Triton-AI/evGoKart-mechanical-system/evGo-Kart CAD/steering frame/156B True Steering_Kart Assembly.gif

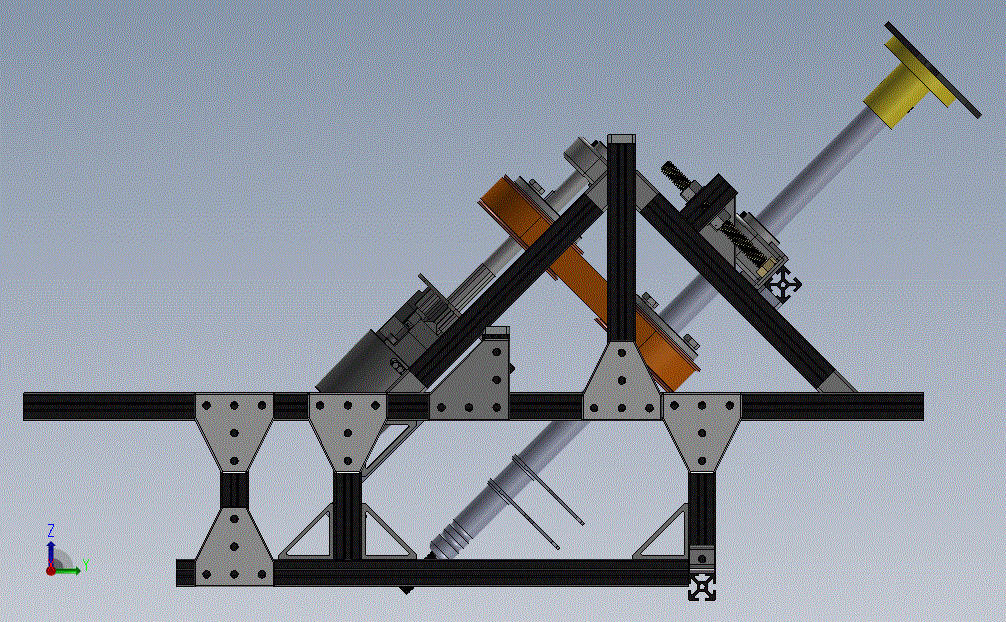
evGo-Kart CAD/steering frame/156B True Steering_Kart Assembly.gif
