Triton-AI/evGoKart-mechanical-system/evGo-Kart CAD/camera system/Livox Lidar Assembly_proto.jpg

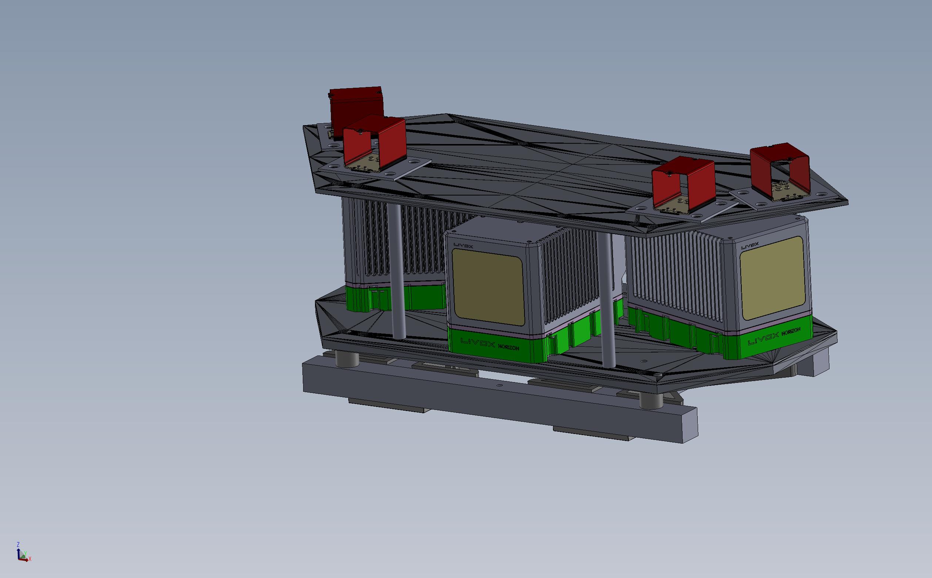
evGo-Kart CAD/camera system/Livox Lidar Assembly_proto.jpg
