Triton-AI/evGoKart-mechanical-system/evGo-Kart CAD/camera system/Go-Kart & Perception SW files/steering motor assembly comp/MAXPlanetary 3-Stage.STEP.SLDASM

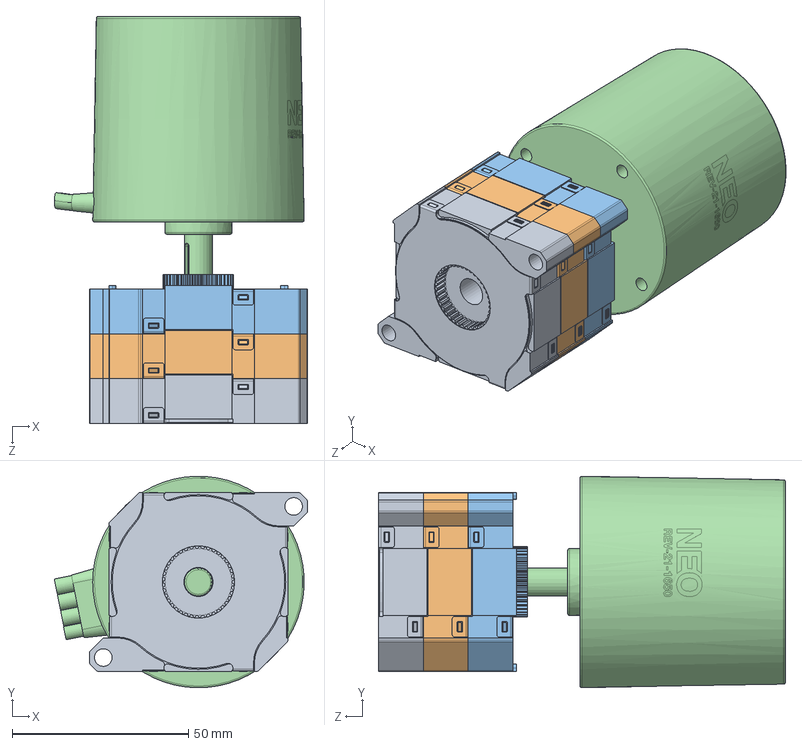
[picture p3: CAD file, 2022-07-24]
evGo-Kart CAD/camera system/Go-Kart & Perception SW files/steering motor assembly comp/MAXPlanetary 3-Stage.STEP.SLDASM
71.8 x 60.0 x 115.4 mm
REV-21-2101.stp
REV-21-2102.stp
REV-21-2103.stp
REV-21-1650.stp
