Triton-AI/evGoKart-mechanical-system/evGo-Kart CAD/steering frame/True Steering_Kart Assembly SolidWorks files/Custom Parts and Sub-Assemblies/Steering Belt Adjustment Mount/Steering Mount and Adjuster Main.STL

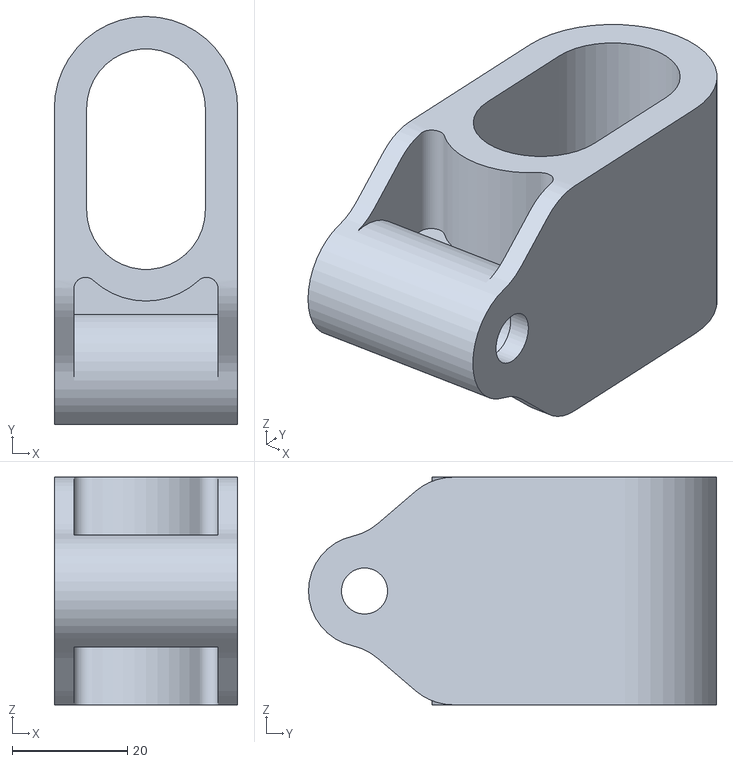
[picture p4: CAD file, 2022-07-23]
evGo-Kart CAD/steering frame/True Steering_Kart Assembly SolidWorks files/Custom Parts and Sub-Assemblies/Steering Belt Adjustment Mount/Steering Mount and Adjuster Main.STL
31.8 x 70.8 x 39.5
