Triton-AI/evGoKart-mechanical-system/evGo-Kart CAD/camera system/Go-Kart & Perception SW files/MAXPlanetary 3 parts/REV-25-2109_3-Stage (No Shaft, For NEO).STEP.SLDASM

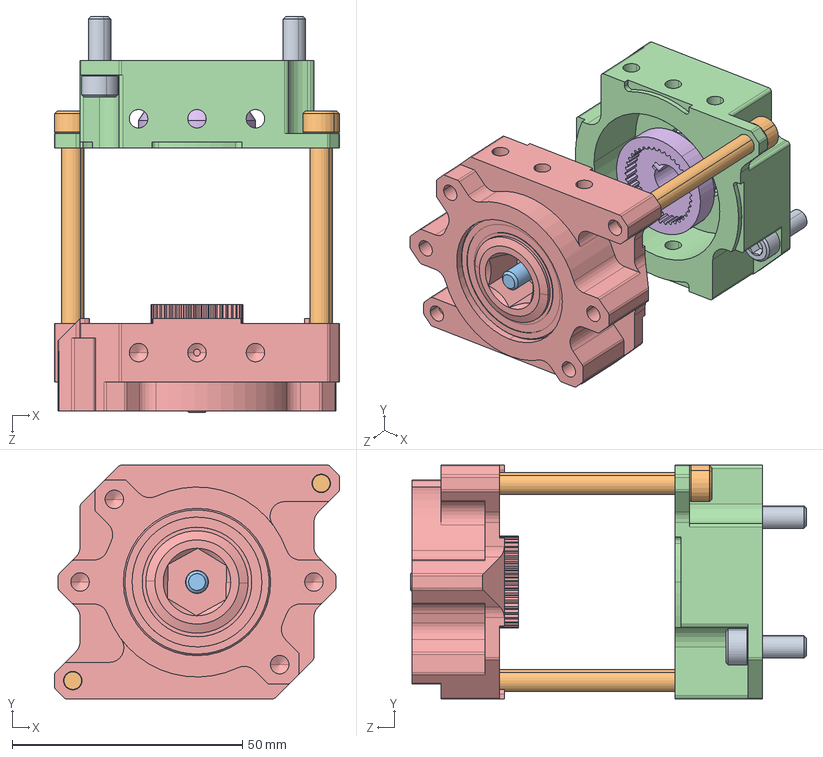
[picture p5: CAD file, 2022-07-24]
evGo-Kart CAD/camera system/Go-Kart & Perception SW files/MAXPlanetary 3 parts/REV-25-2109_3-Stage (No Shaft, For NEO).STEP.SLDASM
61.9 x 50.8 x 86.0 mm
#10 Socket Head Cap Screws_0.500in Long.STEP x 2
#10 Socket Head Cap Screws_2.000in Long.STEP x 2
#10-32 Button Head Cap Screws_0.500in Long.STEP
REV-21-2106.STEP
REV-21-2104.STEP
REV-21-2108.STEP
