Triton-AI/evGoKart-mechanical-system/evGo-Kart CAD/steering frame/True Steering_Kart Assembly SolidWorks files/Custom Parts and Sub-Assemblies/Steering Belt Adjustment Mount/Custom Parts/Steering Mount and Adjuster Main.SLDPRT

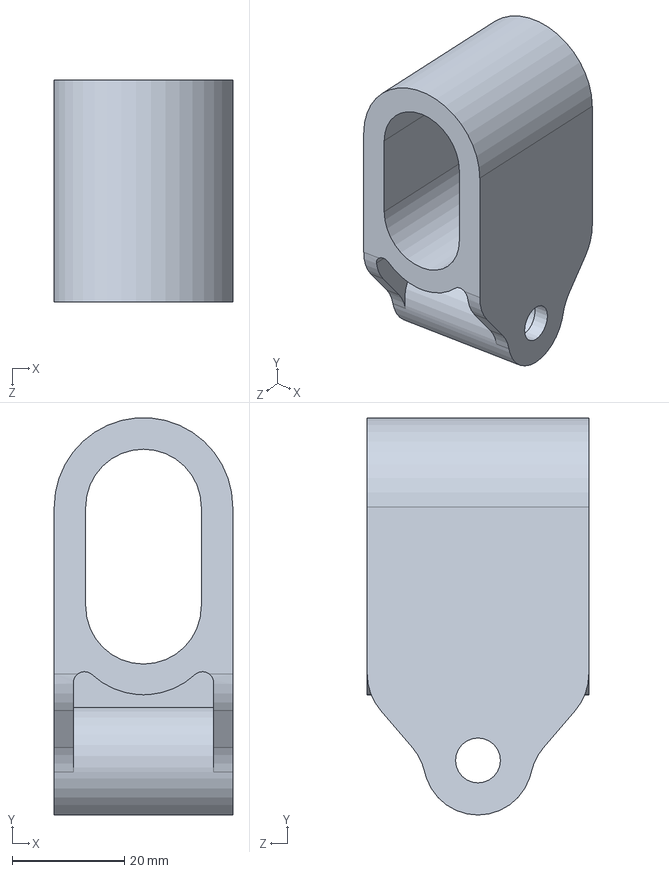
[picture p6: CAD file, 2022-07-23]
evGo-Kart CAD/steering frame/True Steering_Kart Assembly SolidWorks files/Custom Parts and Sub-Assemblies/Steering Belt Adjustment Mount/Custom Parts/Steering Mount and Adjuster Main.SLDPRT
31.8 x 70.8 x 39.5 mm
