Triton-AI/evGoKart-mechanical-system/evGo-Kart CAD/camera system/Go-Kart & Perception SW files/MAXPlanetary 3 parts/REV-25-2109_3-Stage components/REV-25-2107_3-Stage.STEP.SLDASM

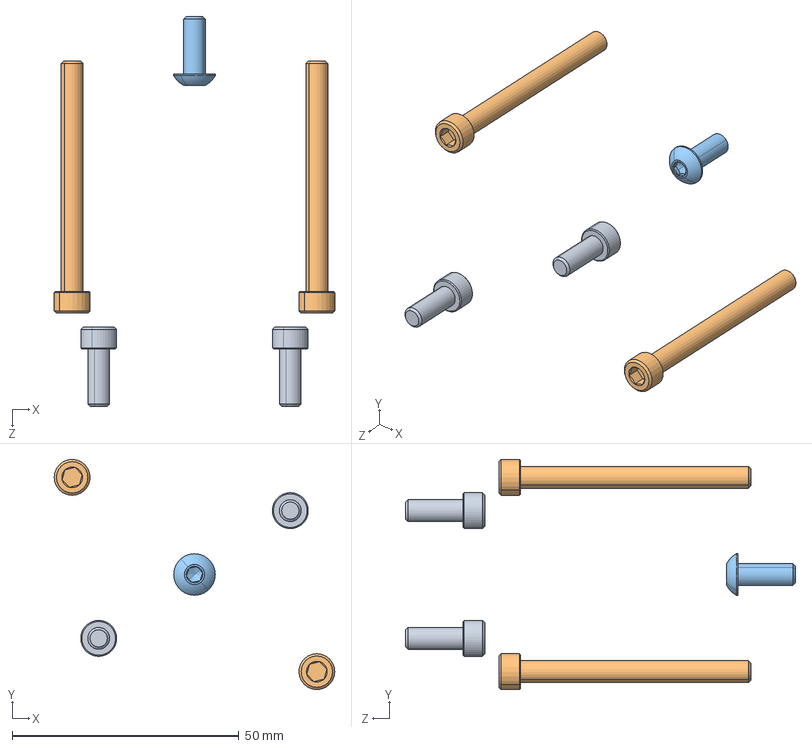
[picture p7: CAD file, 2022-07-24]
evGo-Kart CAD/camera system/Go-Kart & Perception SW files/MAXPlanetary 3 parts/REV-25-2109_3-Stage components/REV-25-2107_3-Stage.STEP.SLDASM
61.9 x 50.8 x 86.0 mm
#10 Socket Head Cap Screws_0.500in Long.STEP x 2
#10 Socket Head Cap Screws_2.000in Long.STEP x 2
#10-32 Button Head Cap Screws_0.500in Long.STEP
