Triton-AI/evGoKart-mechanical-system/evGo-Kart CAD/camera system/Go-Kart & Perception SW files/Livox Lidar Assembly parts/horizon_out_model_asm components/YC_XC_DD000261_ASM_8_ASM.stp.SLDASM

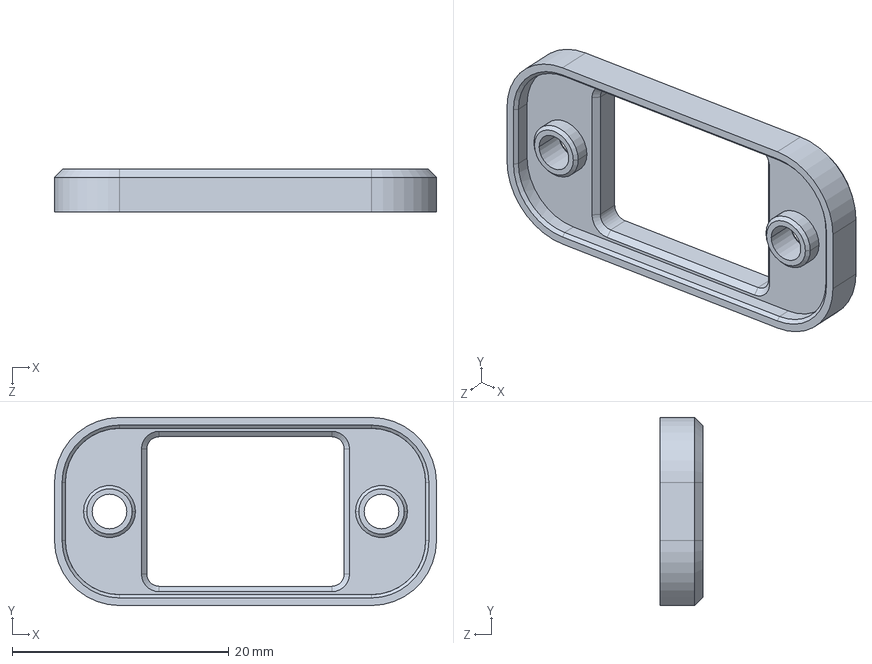
[picture p8: CAD file, 2022-07-24]
evGo-Kart CAD/camera system/Go-Kart & Perception SW files/Livox Lidar Assembly parts/horizon_out_model_asm components/YC_XC_DD000261_ASM_8_ASM.stp.SLDASM
35.2 x 17.3 x 4.00 mm
