Triton-AI/evGoKart-mechanical-system/evGo-Kart CAD/camera system/Go-Kart & Perception SW files/Livox Lidar Assembly parts/Mako-G_C-Mount.STEP.SLDASM

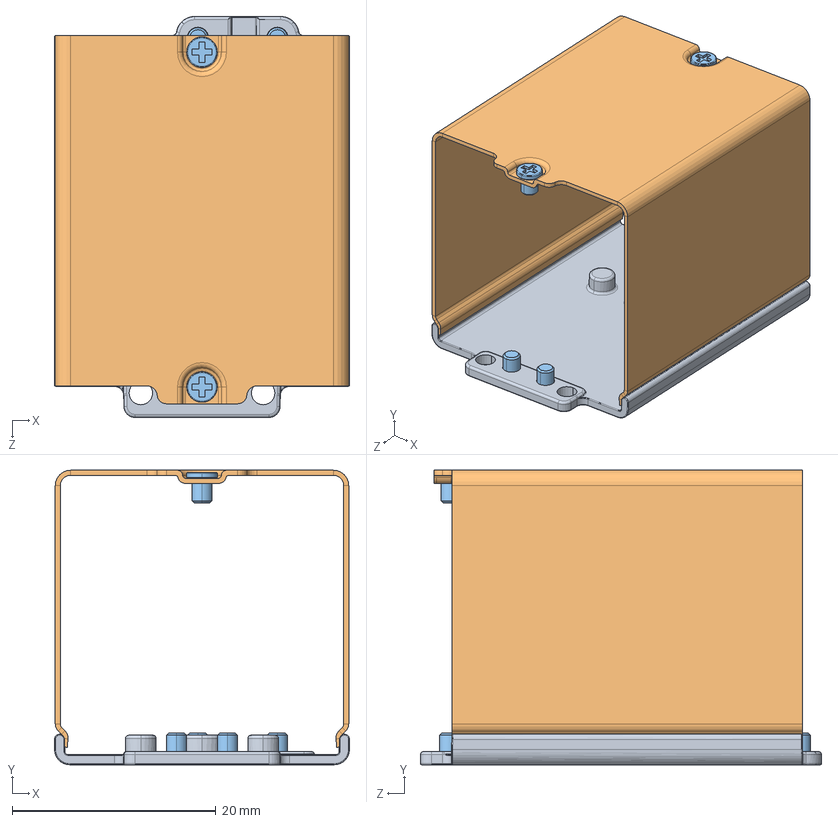
[picture p9: CAD file, 2022-07-24]
evGo-Kart CAD/camera system/Go-Kart & Perception SW files/Livox Lidar Assembly parts/Mako-G_C-Mount.STEP.SLDASM
28.9 x 28.9 x 39.3 mm
11044-_Z02_Mako-G_Boden_ZDG_pulverlackiert_St_ckliste.STEP
4605-_Z04_Mako-PoE_Deckel_nasslackiert+bedruckt_STP-Erstellung ohne Logos.STEP
9533_Flachkopf-Schraube mit KS M2x2.4.STEP x 6
