Triton-AI/evGoKart-mechanical-system/evGo-Kart CAD/camera system/Go-Kart & Perception SW files/Livox Lidar Assembly parts/horizon_out_model_asm.stp.SLDASM

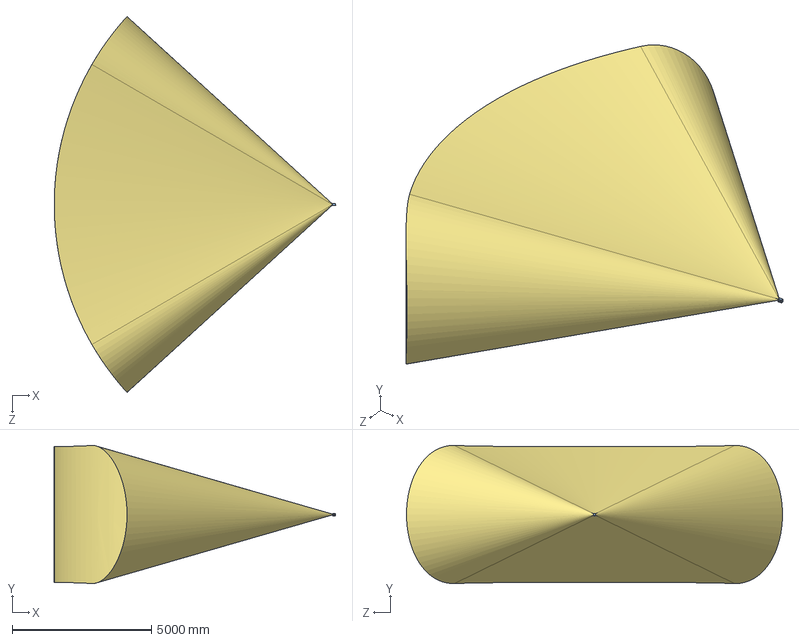
[picture p10: CAD file, 2022-07-24]
evGo-Kart CAD/camera system/Go-Kart & Perception SW files/Livox Lidar Assembly parts/horizon_out_model_asm.stp.SLDASM
10121.6 x 4966.1 x 13519.3 mm
YC_WJ_ZZ003972_68.stp
YC_WJ_ZZ003974_79.stp
YC_WJ_ZZ003978_7.stp
YC_WJ_ZZ003976_2.stp
YC_QT_BL000034_25.stp
YC_JD_JD000348_9.stp
YC_WJ_LL000431_17.stp x 19
YC_WJ_L00410_1.stp x 6
YC_WJ_LL000294_01_1.stp x 2
YC_WJ_L00028_1.stp x 4
YC_WJ_LL000308_1.stp x 4
4040_AFB0412VHA_1.stp
YC_WJ_LL000202_01_1.stp x 4
YC_WJ_L00157_02_3.stp x 2
