Triton-AI/evGoKart-mechanical-system/evGo-Kart CAD/camera system/Go-Kart & Perception SW files/Go-Kart components/Front tire.SLDPRT

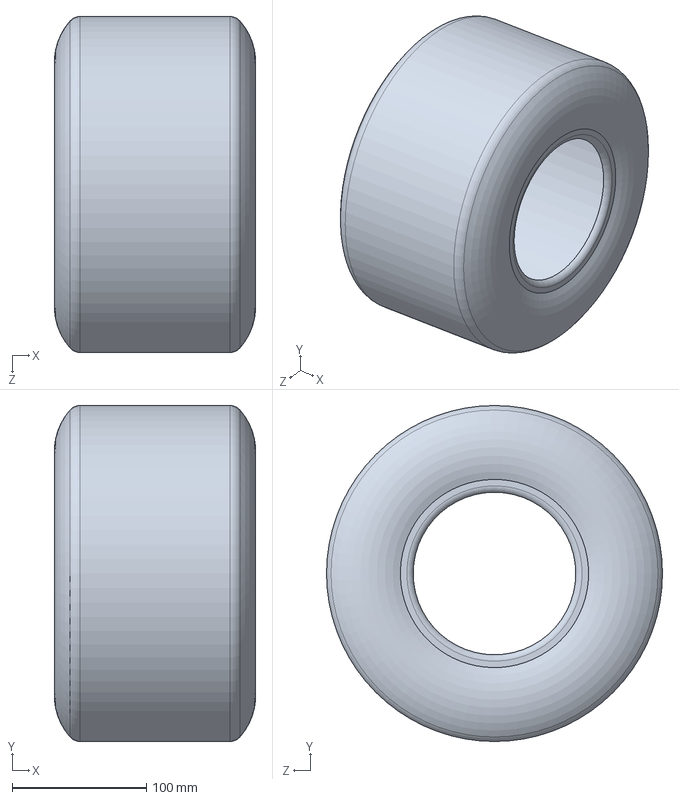
[picture p11: CAD file, 2022-07-24]
evGo-Kart CAD/camera system/Go-Kart & Perception SW files/Go-Kart components/Front tire.SLDPRT
149.7 x 250.0 x 250.0 mm
