Triton-AI/evGoKart-mechanical-system/evGo-Kart CAD/camera system/Go-Kart & Perception SW files/Livox Lidar Assembly parts/MAKOcam_1.68mm_plate.SLDPRT

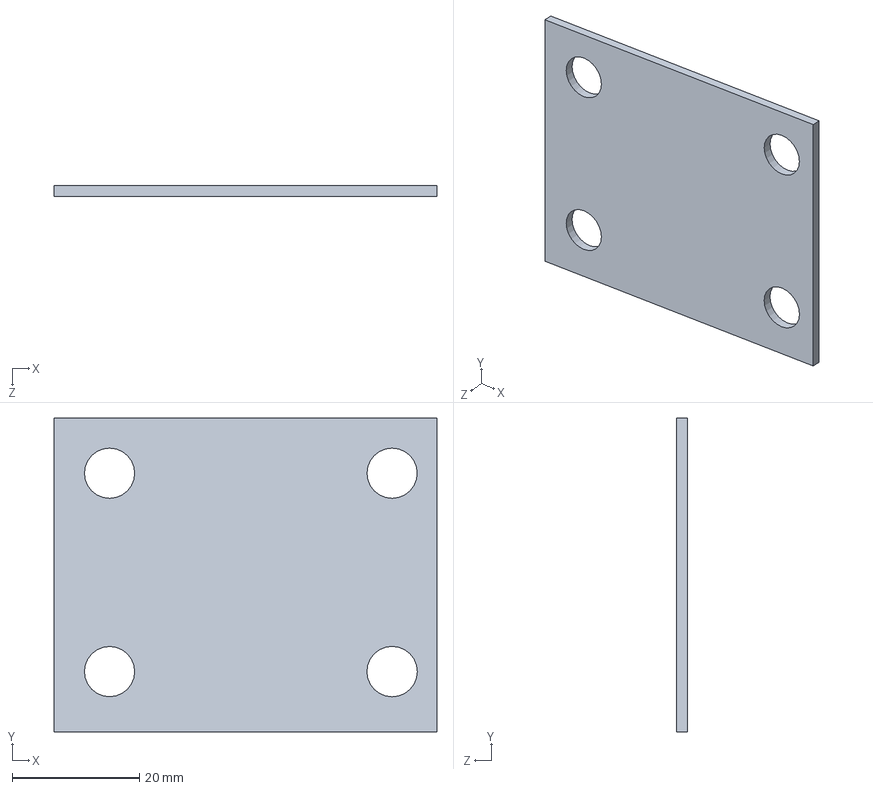
[picture p12: CAD file, 2022-07-24]
evGo-Kart CAD/camera system/Go-Kart & Perception SW files/Livox Lidar Assembly parts/MAKOcam_1.68mm_plate.SLDPRT
60.2 x 49.3 x 1.69 mm
