Triton-AI/evGoKart-mechanical-system/evGo-Kart CAD/camera system/Go-Kart & Perception SW files/Machined/Brake Mount UHI version.stp.SLDPRT

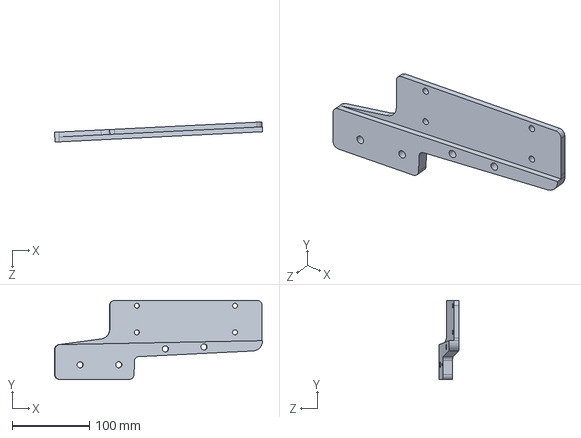
[picture p13: CAD file, 2022-07-24]
evGo-Kart CAD/camera system/Go-Kart & Perception SW files/Machined/Brake Mount UHI version.stp.SLDPRT
268.6 x 102.3 x 26.0 mm
