Triton-AI/evGoKart-mechanical-system/evGo-Kart CAD/steering frame/True Steering_Kart Assembly SolidWorks files/Custom Parts and Sub-Assemblies/Aluminum Cross Bar.SLDPRT

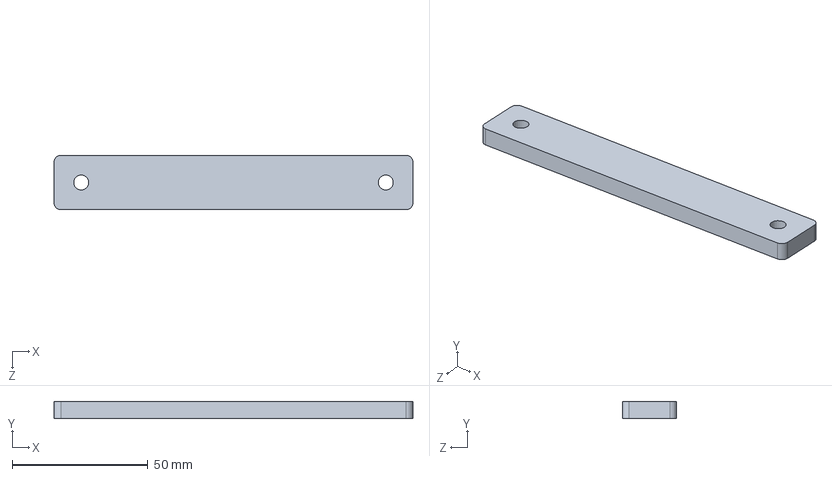
[picture p15: CAD file, 2022-07-23]
evGo-Kart CAD/steering frame/True Steering_Kart Assembly SolidWorks files/Custom Parts and Sub-Assemblies/Aluminum Cross Bar.SLDPRT
132.0 x 6.35 x 20.0 mm
