Triton-AI/evGoKart-mechanical-system/evGo-Kart CAD/steering frame/True Steering_Kart Assembly SolidWorks files/Custom Parts and Sub-Assemblies/Steering Shaft/KeyStock.SLDPRT

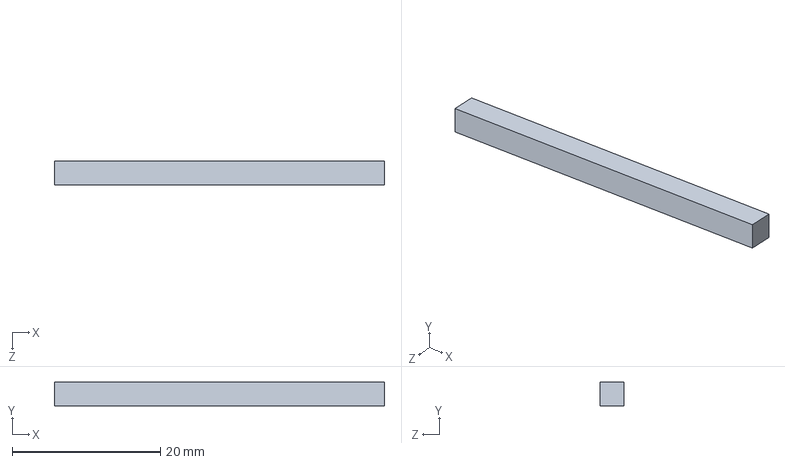
[picture p17: CAD file, 2022-07-23]
evGo-Kart CAD/steering frame/True Steering_Kart Assembly SolidWorks files/Custom Parts and Sub-Assemblies/Steering Shaft/KeyStock.SLDPRT
44.5 x 3.17 x 3.17 mm
