Triton-AI/evGoKart-mechanical-system/evGo-Kart CAD/steering frame/True Steering_Kart Assembly SolidWorks files/Misc. Parts/Steering Wheel True.SLDPRT

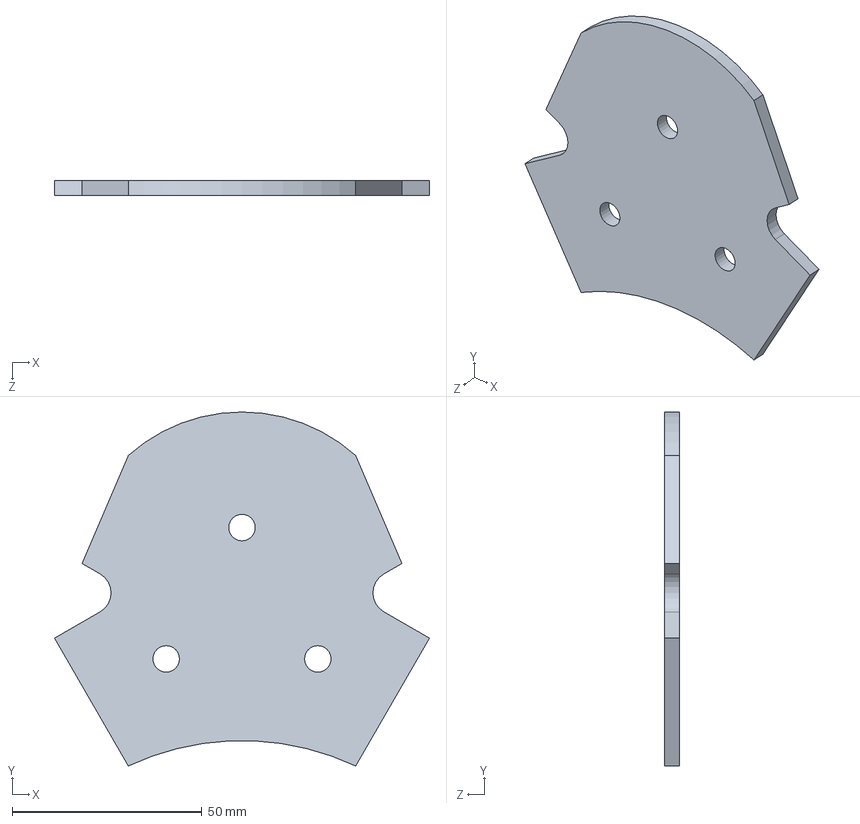
[picture p18: CAD file, 2022-07-23]
evGo-Kart CAD/steering frame/True Steering_Kart Assembly SolidWorks files/Misc. Parts/Steering Wheel True.SLDPRT
98.9 x 93.4 x 4.00 mm
