Triton-AI/evGoKart-mechanical-system/evGo-Kart CAD/camera system/Go-Kart & Perception SW files/Go-Kart components/Tie rod 2.SLDPRT

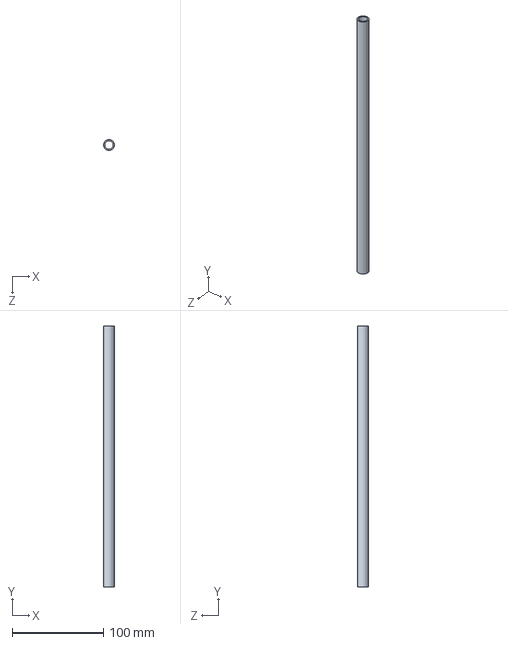
[picture p19: CAD file, 2022-07-24]
evGo-Kart CAD/camera system/Go-Kart & Perception SW files/Go-Kart components/Tie rod 2.SLDPRT
11.9 x 286.5 x 11.9 mm
