Triton-AI/evGoKart-mechanical-system/evGo-Kart CAD/camera system/Go-Kart & Perception SW files/Machined/motorbracketplate.SLDPRT

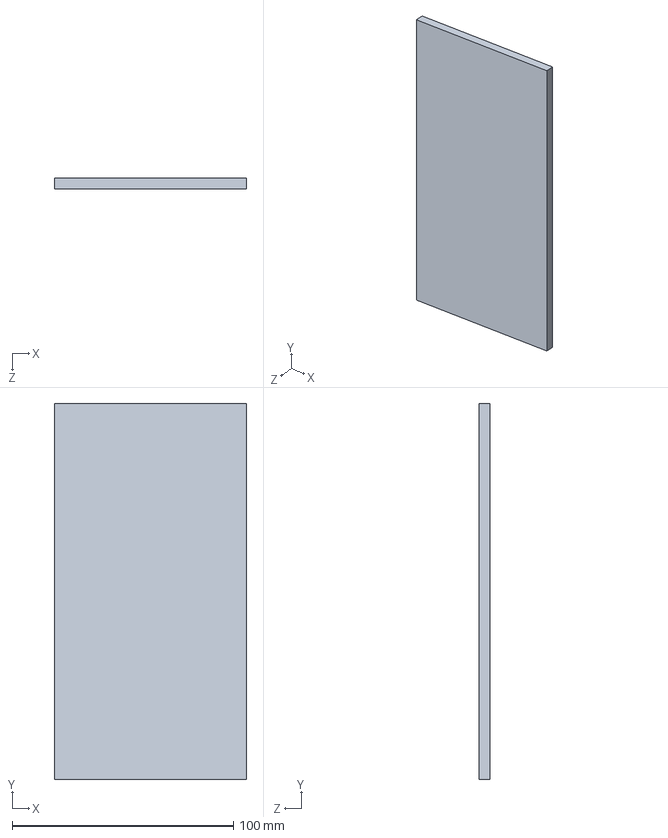
[picture p20: CAD file, 2022-07-24]
evGo-Kart CAD/camera system/Go-Kart & Perception SW files/Machined/motorbracketplate.SLDPRT
87.0 x 170.0 x 5.00 mm
