Triton-AI/evGoKart-mechanical-system/evGo-Kart CAD/steering frame/True Steering_Kart Assembly SolidWorks files/Custom Parts and Sub-Assemblies/Steering Belt Adjustment Mount/Custom Parts/Original Steering Mount.SLDPRT

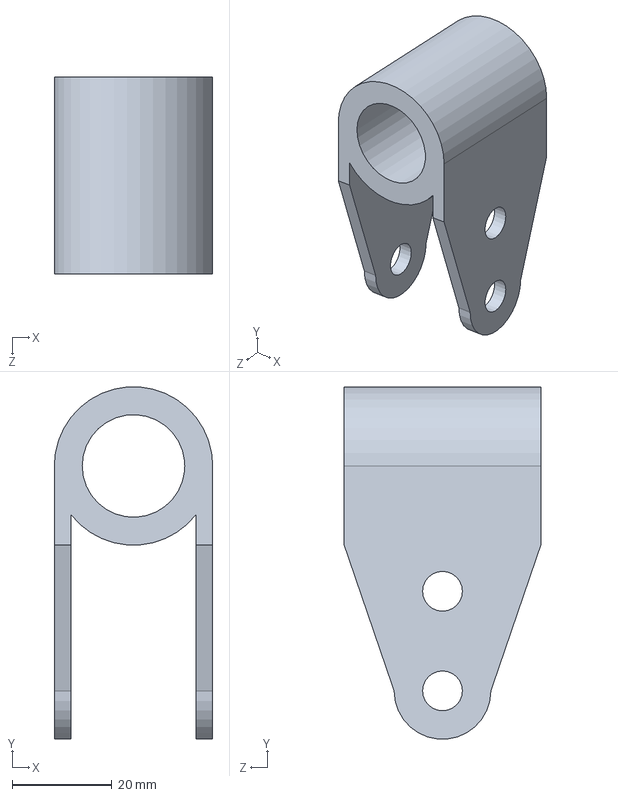
[picture p21: CAD file, 2022-07-23]
evGo-Kart CAD/steering frame/True Steering_Kart Assembly SolidWorks files/Custom Parts and Sub-Assemblies/Steering Belt Adjustment Mount/Custom Parts/Original Steering Mount.SLDPRT
31.8 x 70.7 x 39.5 mm
