Triton-AI/evGoKart-mechanical-system/evGo-Kart CAD/steering frame/True Steering_Kart Assembly SolidWorks files/Custom Parts and Sub-Assemblies/Steering Shaft/rounded_hexbar.SLDPRT

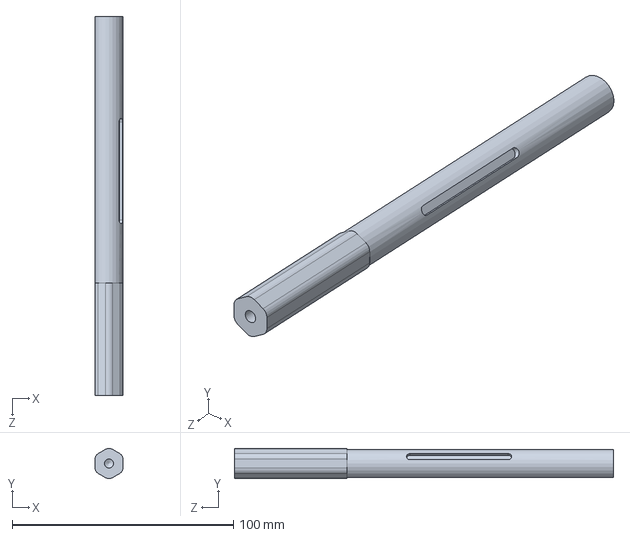
[picture p22: CAD file, 2022-07-23]
evGo-Kart CAD/steering frame/True Steering_Kart Assembly SolidWorks files/Custom Parts and Sub-Assemblies/Steering Shaft/rounded_hexbar.SLDPRT
12.7 x 13.8 x 171.4 mm
