Triton-AI/evGoKart-mechanical-system/evGo-Kart CAD/steering frame/True Steering_Kart Assembly SolidWorks files/Misc. Parts/TimingBelt.SLDPRT

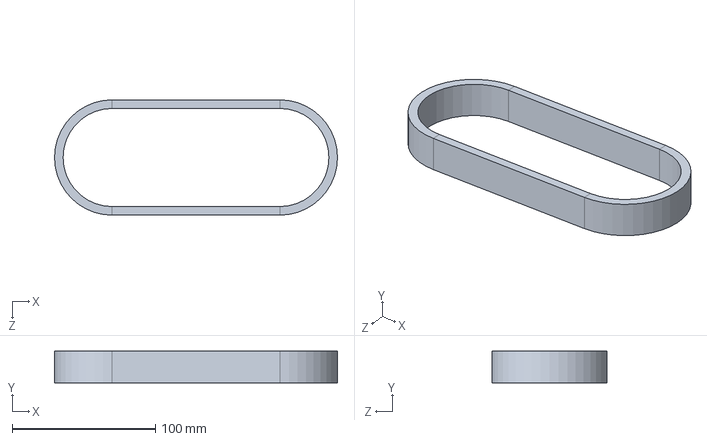
[picture p23: CAD file, 2022-07-23]
evGo-Kart CAD/steering frame/True Steering_Kart Assembly SolidWorks files/Misc. Parts/TimingBelt.SLDPRT
197.5 x 22.0 x 80.5 mm
