Triton-AI/evGoKart-mechanical-system/evGo-Kart CAD/camera system/Go-Kart & Perception SW files/Go-Kart components/Stub axle left.SLDPRT

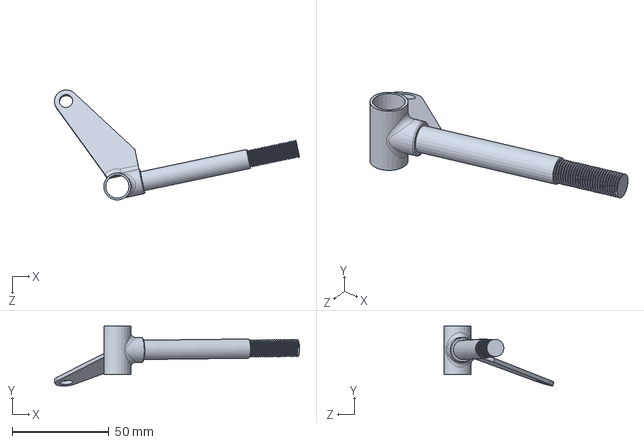
[picture p24: CAD file, 2022-07-24]
evGo-Kart CAD/camera system/Go-Kart & Perception SW files/Go-Kart components/Stub axle left.SLDPRT
126.6 x 31.0 x 56.9 mm
