Triton-AI/evGoKart-mechanical-system/evGo-Kart CAD/camera system/Go-Kart & Perception SW files/MAXPlanetary 3 parts/REV-21-1650.stp.SLDPRT

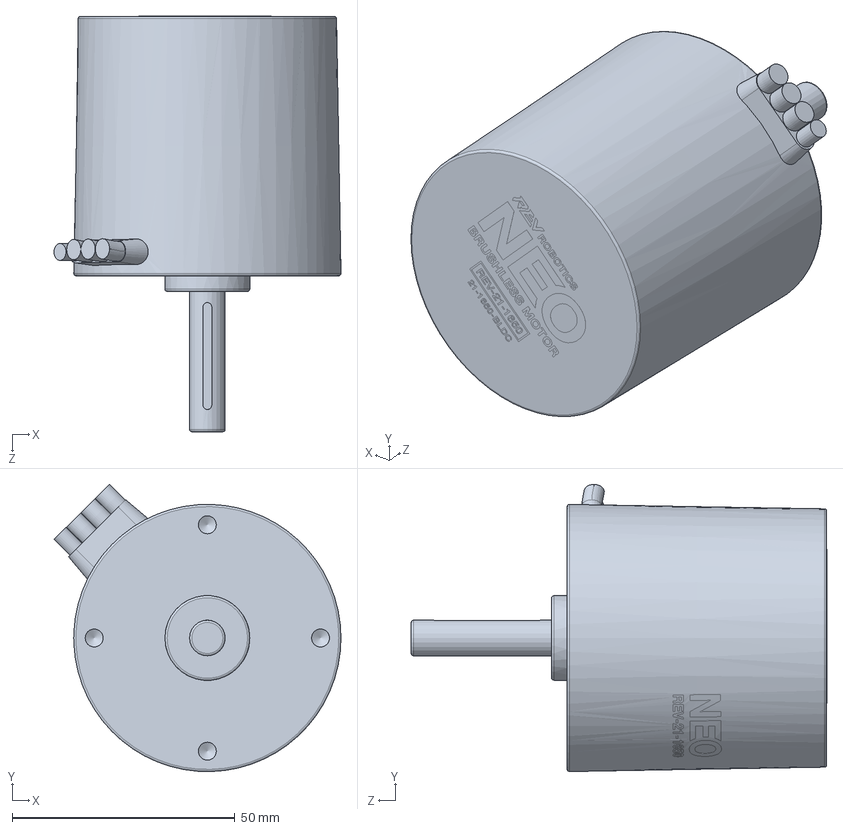
[picture p25: CAD file, 2022-07-24]
evGo-Kart CAD/camera system/Go-Kart & Perception SW files/MAXPlanetary 3 parts/REV-21-1650.stp.SLDPRT
64.4 x 64.4 x 93.3 mm
