Triton-AI/evGoKart-mechanical-system/evGo-Kart CAD/camera system/Go-Kart & Perception SW files/steering motor assembly comp/REV-21-1842.stp.SLDPRT

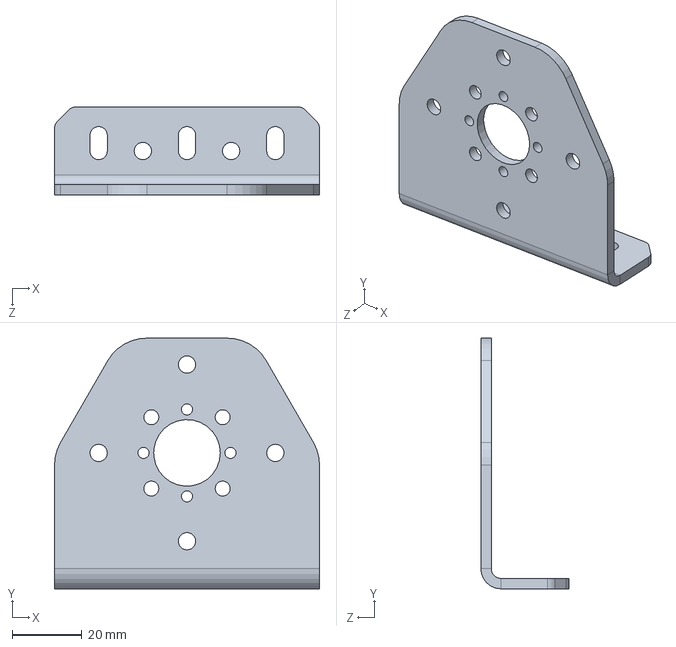
[picture p26: CAD file, 2022-07-24]
evGo-Kart CAD/camera system/Go-Kart & Perception SW files/steering motor assembly comp/REV-21-1842.stp.SLDPRT
76.2 x 72.1 x 25.4 mm
