Triton-AI/evGoKart-mechanical-system/evGo-Kart CAD/camera system/Go-Kart & Perception SW files/Go-Kart components/bottom support.SLDPRT

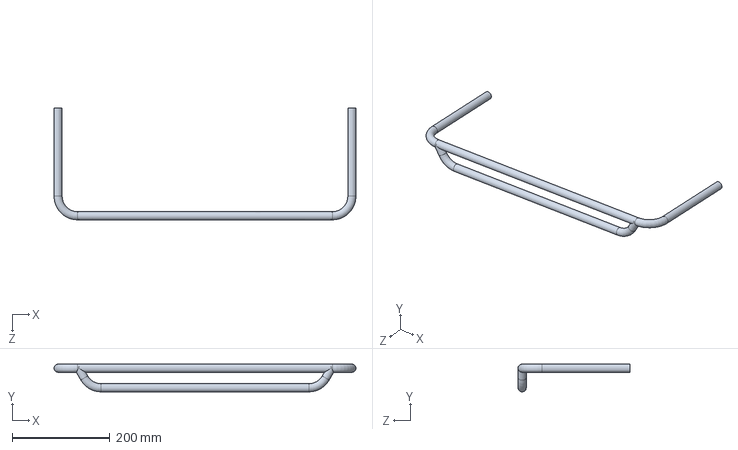
[picture p27: CAD file, 2022-07-24]
evGo-Kart CAD/camera system/Go-Kart & Perception SW files/Go-Kart components/bottom support.SLDPRT
616.7 x 56.7 x 228.4 mm
