Triton-AI/evGoKart-mechanical-system/evGo-Kart CAD/steering frame/True Steering_Kart Assembly SolidWorks files/Custom Parts and Sub-Assemblies/Steering Belt Adjustment Mount/Custom Parts/Forks Mockup.SLDPRT

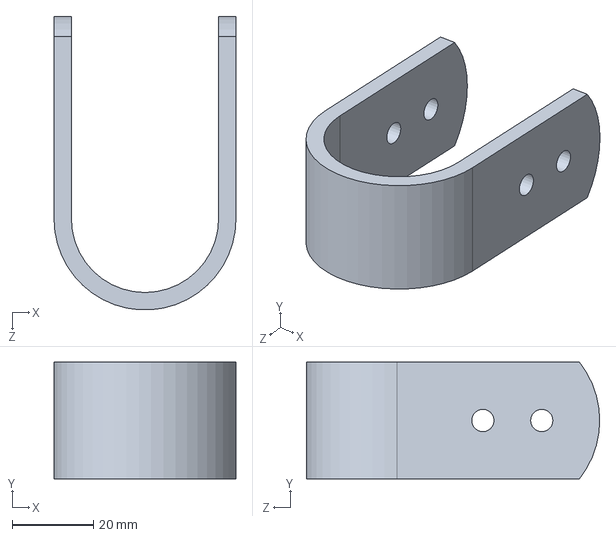
[picture p28: CAD file, 2022-07-23]
evGo-Kart CAD/steering frame/True Steering_Kart Assembly SolidWorks files/Custom Parts and Sub-Assemblies/Steering Belt Adjustment Mount/Custom Parts/Forks Mockup.SLDPRT
44.9 x 28.8 x 72.4 mm
