Triton-AI/evGoKart-mechanical-system/evGo-Kart CAD/camera system/Go-Kart & Perception SW files/Go-Kart components/Tire+rim connector.SLDPRT

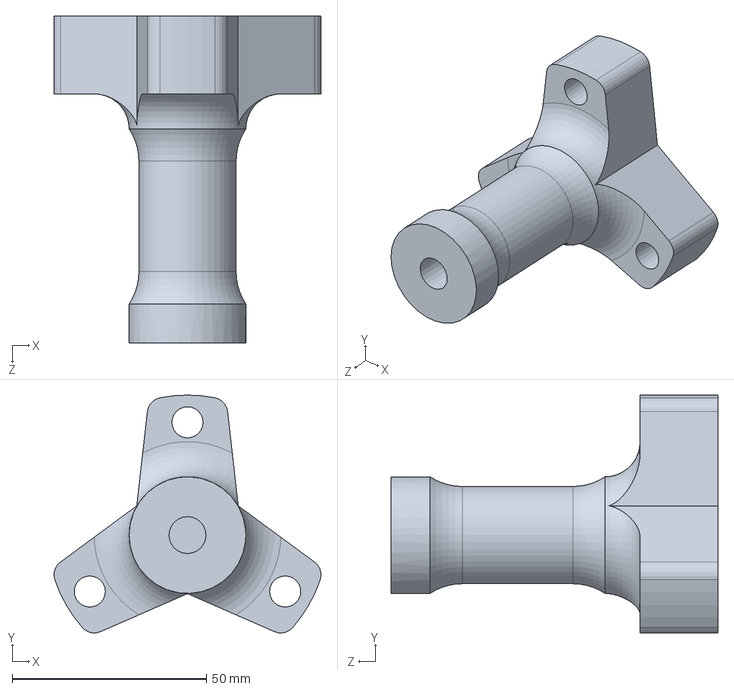
[picture p29: CAD file, 2022-07-24]
evGo-Kart CAD/camera system/Go-Kart & Perception SW files/Go-Kart components/Tire+rim connector.SLDPRT
68.6 x 61.2 x 84.0 mm
