Triton-AI/evGoKart-mechanical-system/evGo-Kart CAD/camera system/Go-Kart & Perception SW files/MAXPlanetary 3 parts/REV-21-2101.stp.SLDPRT

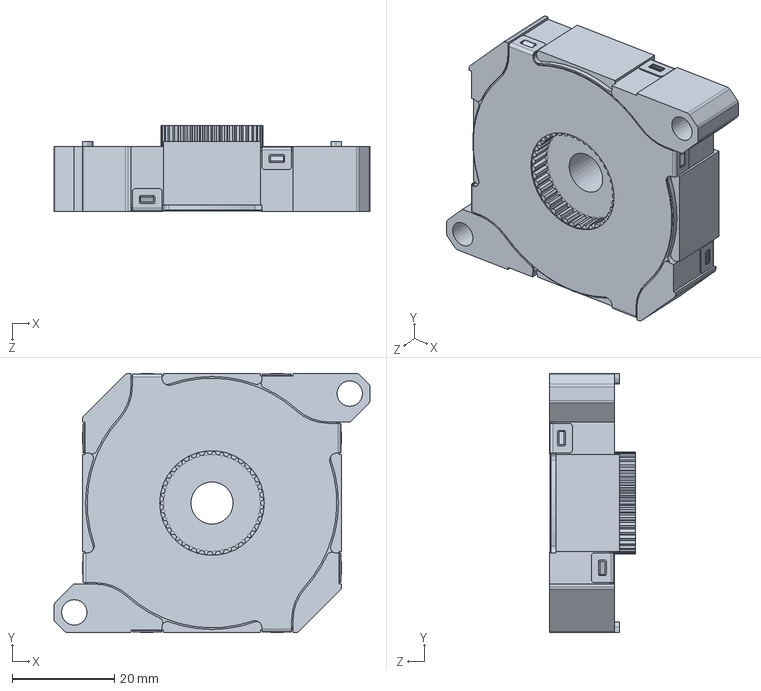
[picture p30: CAD file, 2022-07-24]
evGo-Kart CAD/camera system/Go-Kart & Perception SW files/MAXPlanetary 3 parts/REV-21-2101.stp.SLDPRT
61.9 x 50.8 x 16.8 mm
