Triton-AI/evGoKart-mechanical-system/evGo-Kart CAD/camera system/Go-Kart & Perception SW files/Go-Kart components/Sphere.SLDPRT

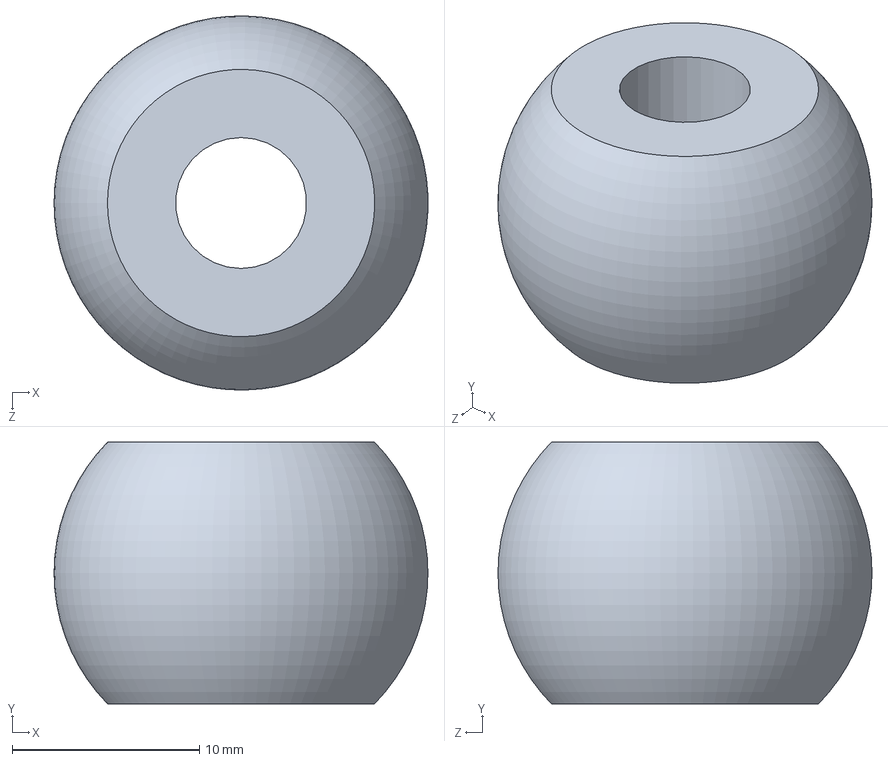
[picture p32: CAD file, 2022-07-24]
evGo-Kart CAD/camera system/Go-Kart & Perception SW files/Go-Kart components/Sphere.SLDPRT
20.0 x 14.0 x 20.0 mm
