Triton-AI/evGoKart-mechanical-system/evGo-Kart CAD/camera system/Go-Kart & Perception SW files/Go-Kart components/Tie rod.SLDPRT

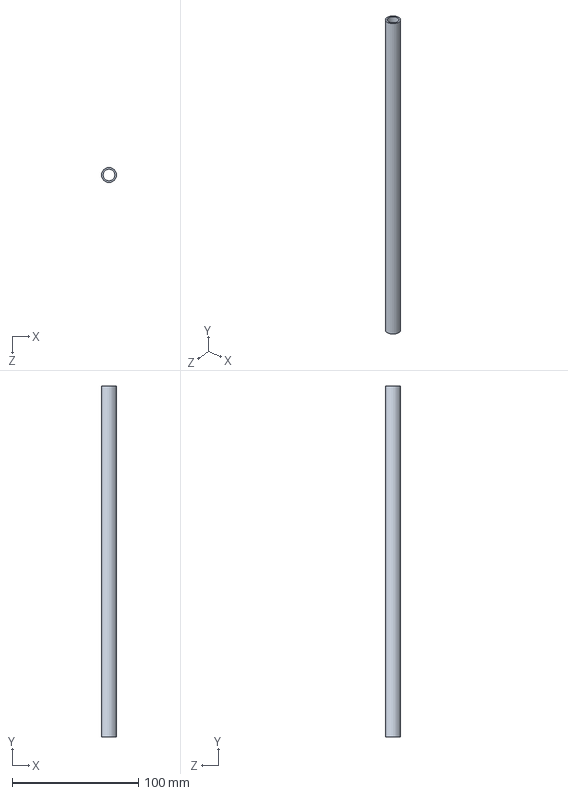
[picture p34: CAD file, 2022-07-24]
evGo-Kart CAD/camera system/Go-Kart & Perception SW files/Go-Kart components/Tie rod.SLDPRT
11.9 x 278.5 x 11.9 mm
