Triton-AI/evGoKart-mechanical-system/evGo-Kart CAD/camera system/Go-Kart & Perception SW files/Livox Lidar Assembly parts/Tslot_sensors_20mm.SLDPRT

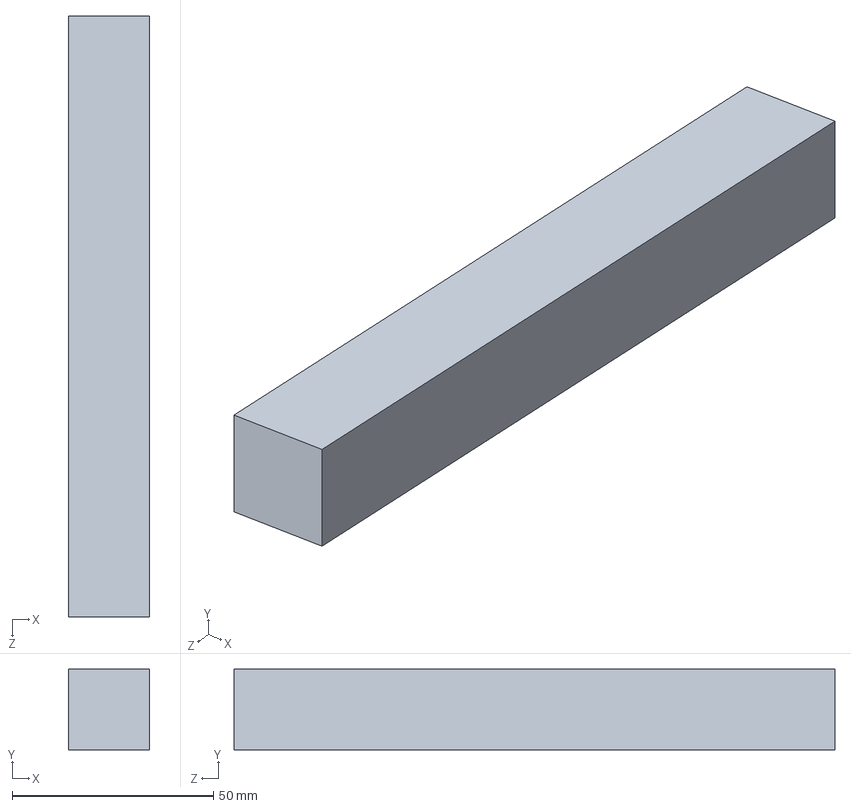
[picture p35: CAD file, 2022-07-24]
evGo-Kart CAD/camera system/Go-Kart & Perception SW files/Livox Lidar Assembly parts/Tslot_sensors_20mm.SLDPRT
20.0 x 20.0 x 149.2 mm
