Triton-AI/evGoKart-mechanical-system/evGo-Kart CAD/camera system/Go-Kart & Perception SW files/Livox Lidar Assembly parts/livoxLIDAR_verticalpoles.SLDPRT

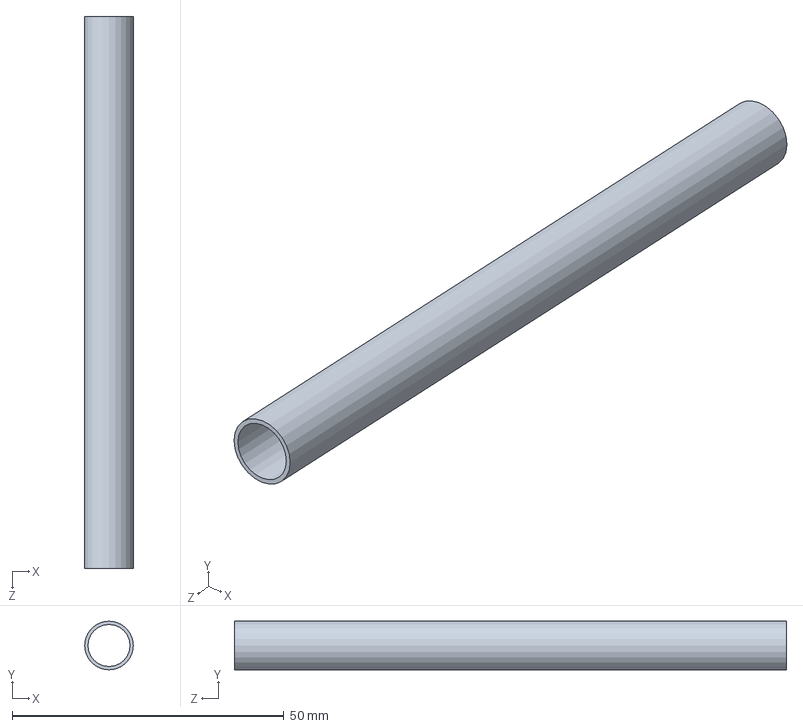
[picture p37: CAD file, 2022-07-24]
evGo-Kart CAD/camera system/Go-Kart & Perception SW files/Livox Lidar Assembly parts/livoxLIDAR_verticalpoles.SLDPRT
8.98 x 8.98 x 101.6 mm
