Triton-AI/evGoKart-mechanical-system/evGo-Kart CAD/camera system/Go-Kart & Perception SW files/Go-Kart components/SW holder.SLDPRT

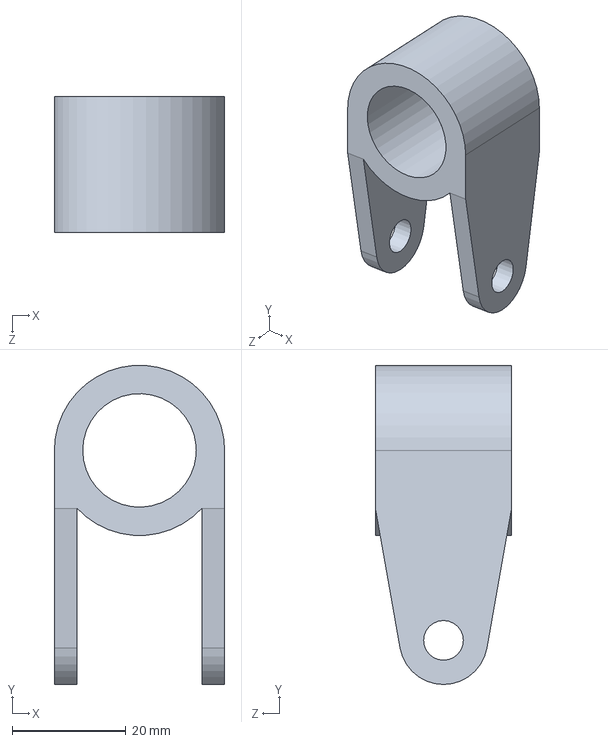
[picture p40: CAD file, 2022-07-24]
evGo-Kart CAD/camera system/Go-Kart & Perception SW files/Go-Kart components/SW holder.SLDPRT
30.0 x 56.2 x 24.0 mm
