Triton-AI/evGoKart-mechanical-system/evGo-Kart CAD/camera system/Go-Kart & Perception SW files/Livox Lidar Assembly parts/ZED2_1-16_aluminum plate.SLDPRT

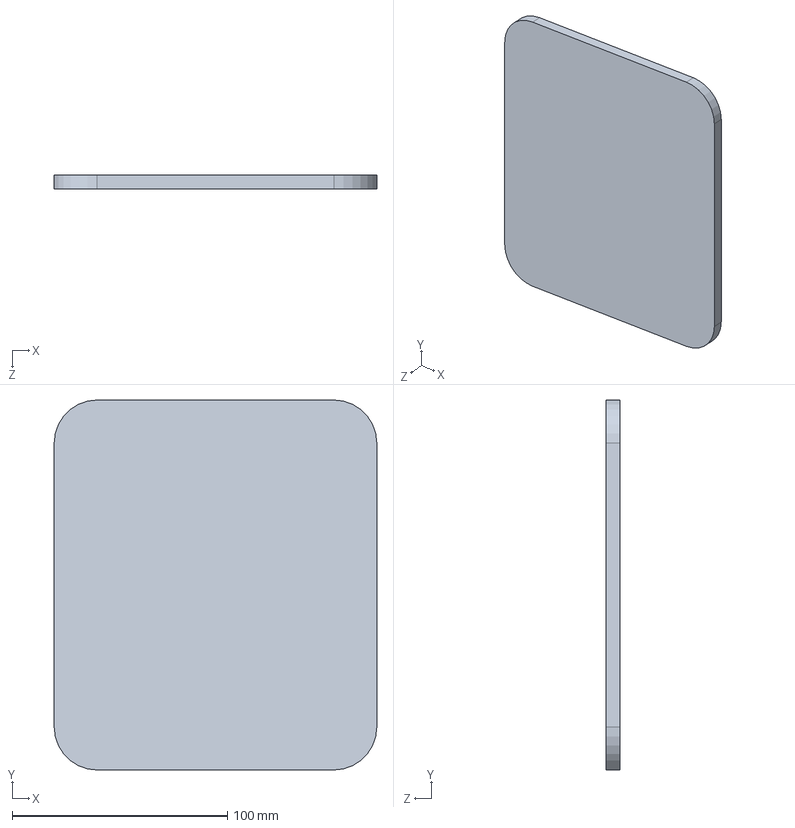
[picture p42: CAD file, 2022-07-24]
evGo-Kart CAD/camera system/Go-Kart & Perception SW files/Livox Lidar Assembly parts/ZED2_1-16_aluminum plate.SLDPRT
150.0 x 172.0 x 6.35 mm
