Triton-AI/evGoKart-mechanical-system/evGo-Kart CAD/camera system/Go-Kart & Perception SW files/Go-Kart components/Stub axle right.SLDPRT

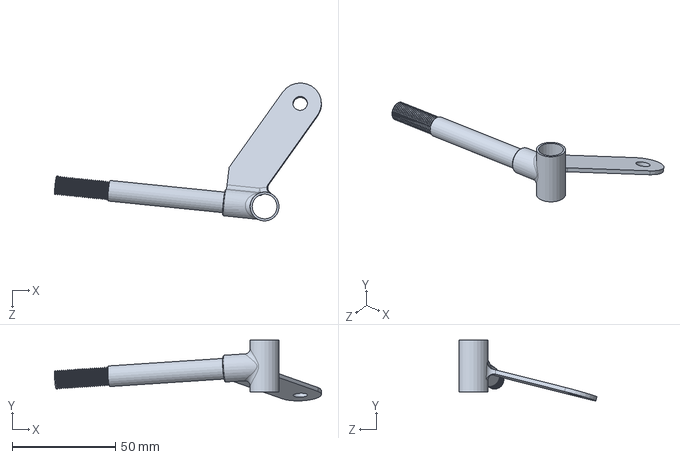
[picture p43: CAD file, 2022-07-24]
evGo-Kart CAD/camera system/Go-Kart & Perception SW files/Go-Kart components/Stub axle right.SLDPRT
129.0 x 29.4 x 66.7 mm
