Triton-AI/evGoKart-mechanical-system/evGo-Kart CAD/camera system/Go-Kart & Perception SW files/Go-Kart components/Steering wheel housing.SLDPRT

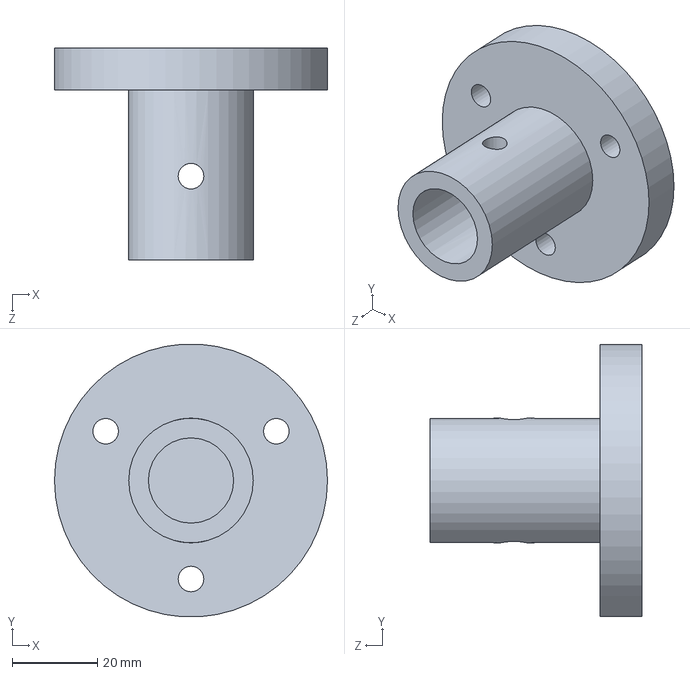
[picture p44: CAD file, 2022-07-24]
evGo-Kart CAD/camera system/Go-Kart & Perception SW files/Go-Kart components/Steering wheel housing.SLDPRT
64.0 x 63.9 x 49.7 mm
