Triton-AI/evGoKart-mechanical-system/evGo-Kart CAD/camera system/Go-Kart & Perception SW files/Go-Kart components/Top-Kart chassis.SLDPRT

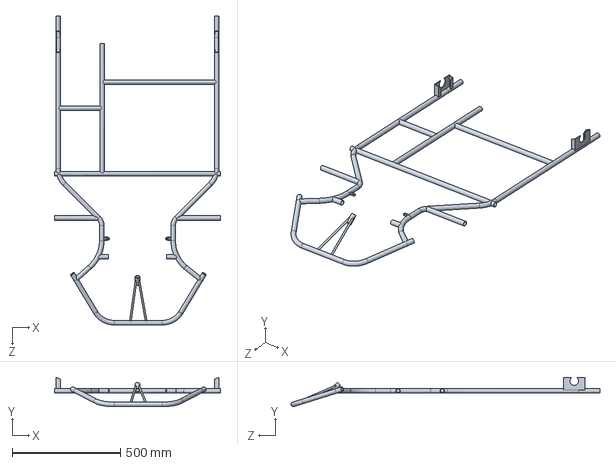
[picture p46: CAD file, 2022-07-24]
evGo-Kart CAD/camera system/Go-Kart & Perception SW files/Go-Kart components/Top-Kart chassis.SLDPRT
768.7 x 135.4 x 1426.6 mm
