Triton-AI/evGoKart-mechanical-system/evGo-Kart CAD/camera system/Go-Kart & Perception SW files/Livox Lidar Assembly parts/Tslot_sensors.SLDPRT

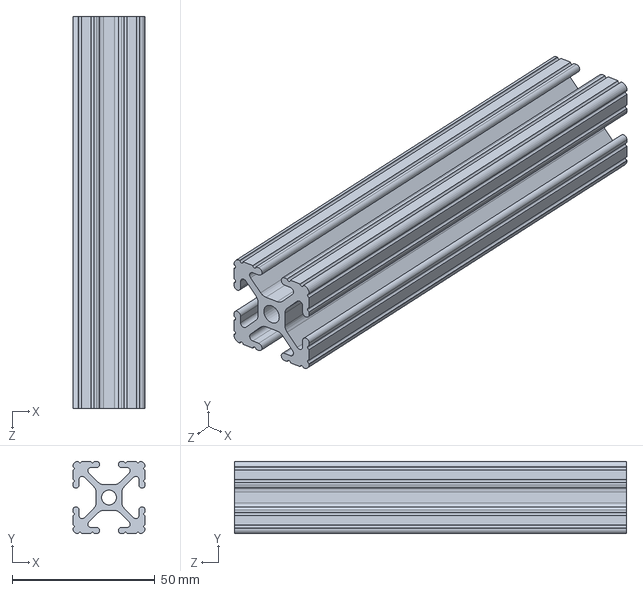
[picture p47: CAD file, 2022-07-24]
evGo-Kart CAD/camera system/Go-Kart & Perception SW files/Livox Lidar Assembly parts/Tslot_sensors.SLDPRT
25.4 x 25.4 x 137.4 mm
