Triton-AI/evGoKart-mechanical-system/evGo-Kart CAD/camera system/Go-Kart & Perception SW files/Go-Kart components/Rear Hub.SLDPRT

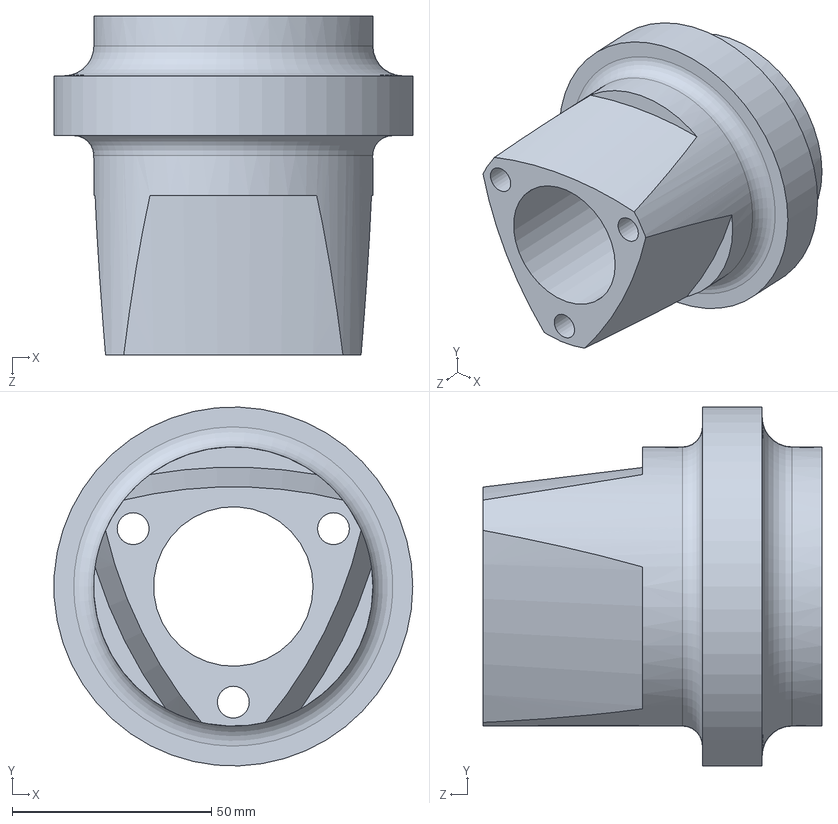
[picture p48: CAD file, 2022-07-24]
evGo-Kart CAD/camera system/Go-Kart & Perception SW files/Go-Kart components/Rear Hub.SLDPRT
89.9 x 90.0 x 85.0 mm
