Triton-AI/evGoKart-mechanical-system/evGo-Kart CAD/camera system/Go-Kart & Perception SW files/Go-Kart components/Rear axle.SLDPRT

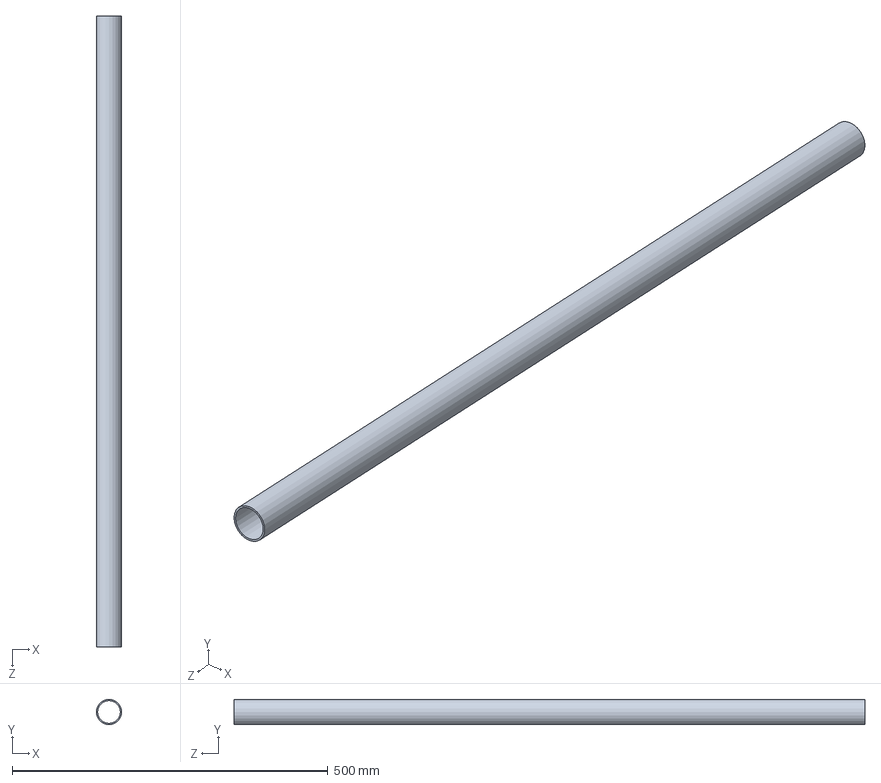
[picture p49: CAD file, 2022-07-24]
evGo-Kart CAD/camera system/Go-Kart & Perception SW files/Go-Kart components/Rear axle.SLDPRT
40.0 x 40.0 x 1000.0 mm
