Triton-AI/evGoKart-mechanical-system/evGo-Kart CAD/camera system/Go-Kart & Perception SW files/Go-Kart components/Steering wheel.SLDPRT

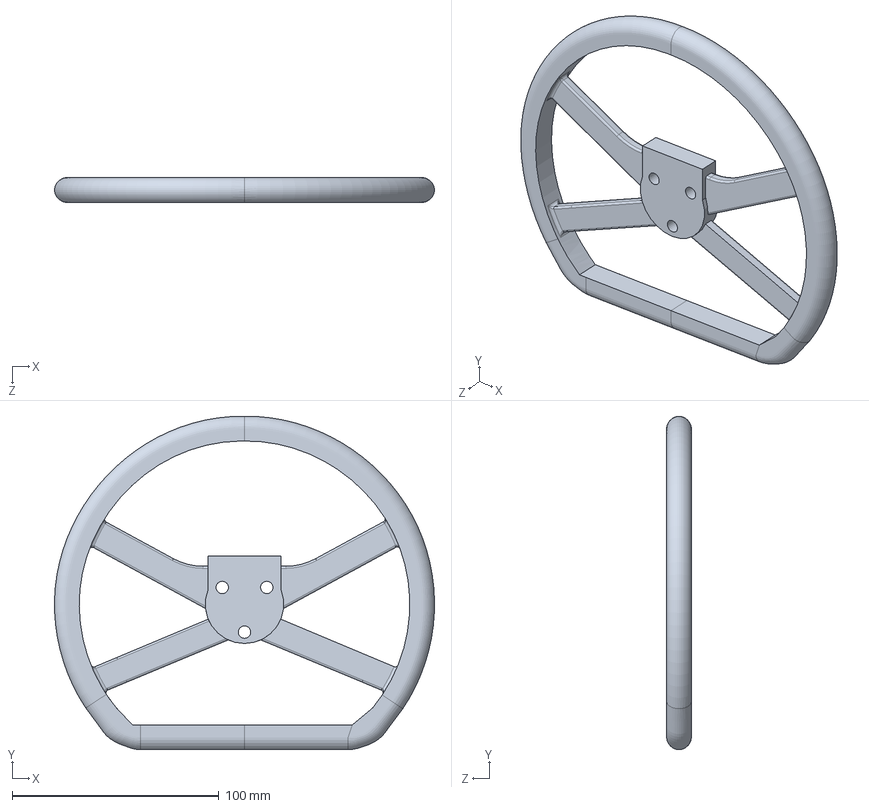
[picture p50: CAD file, 2022-07-24]
evGo-Kart CAD/camera system/Go-Kart & Perception SW files/Go-Kart components/Steering wheel.SLDPRT
183.9 x 161.4 x 12.0 mm
