Triton-AI/evGoKart-mechanical-system/evGo-Kart CAD/camera system/Go-Kart & Perception SW files/Go-Kart components/Steering Wheel shaft.SLDPRT

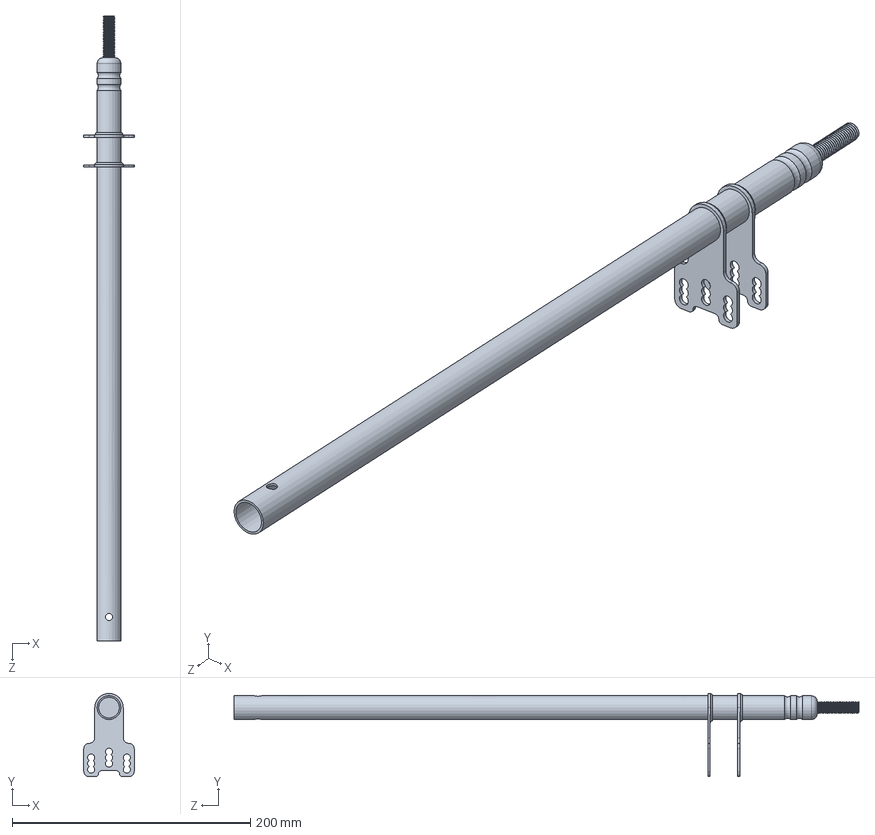
[picture p51: CAD file, 2022-07-24]
evGo-Kart CAD/camera system/Go-Kart & Perception SW files/Go-Kart components/Steering Wheel shaft.SLDPRT
42.5 x 70.0 x 525.0 mm
