Triton-AI/evGoKart-mechanical-system/evGo-Kart CAD/camera system/Go-Kart & Perception SW files/Livox Lidar Assembly parts/ZED2.step.SLDPRT

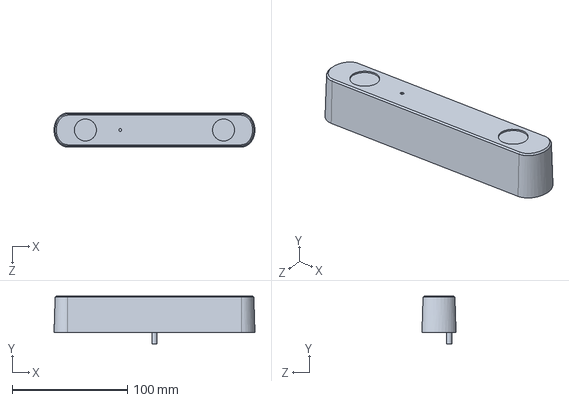
[picture p52: CAD file, 2022-07-24]
evGo-Kart CAD/camera system/Go-Kart & Perception SW files/Livox Lidar Assembly parts/ZED2.step.SLDPRT
174.7 x 41.6 x 29.7 mm
