Triton-AI/evGoKart-mechanical-system/evGo-Kart CAD/camera system/Go-Kart & Perception SW files/Go-Kart components/Sphere enclosure.SLDPRT

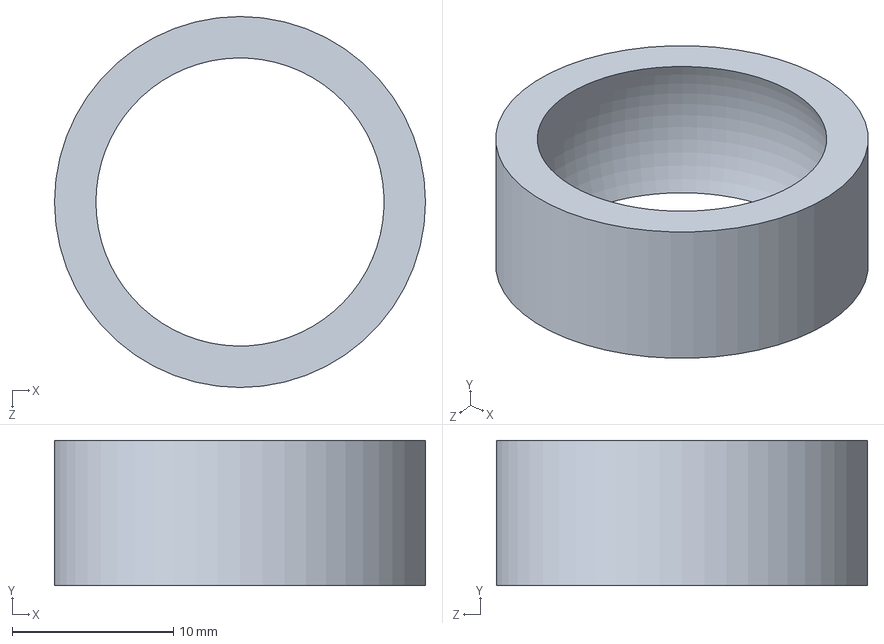
[picture p53: CAD file, 2022-07-24]
evGo-Kart CAD/camera system/Go-Kart & Perception SW files/Go-Kart components/Sphere enclosure.SLDPRT
23.0 x 9.00 x 23.0 mm
