Triton-AI/evGoKart-mechanical-system/(list of files, cad)

Other CAD files:
evGo-Kart CAD/camera system/Go-Kart & Perception SW files/Livox Lidar Assembly parts/horizon_out_model_asm components/YC_XC_DD000261_ASM_8_ASM components/LINE_VT_ASM_2_ASM comp/DD261LINE_ASM_2_ASM.st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
evGo-Kart CAD/camera system/Go-Kart & Perception SW files/Livox Lidar Assembly parts/horizon_out_model_asm components/YC_XC_DD000261_ASM_8_ASM components/LINE_VT_ASM_2_ASM.stp.SLDASM
evGo-Kart CAD/camera system/Go-Kart & Perception SW files/Livox Lidar Assembly parts/horizon_out_model_asm components/YC_XC_DD000261_ASM_8_ASM components/DD261_PLUG_VT1_ASM_4_ASM.stp.SLDASM
evGo-Kart CAD/camera system/Go-Kart & Perception SW files/Livox Lidar Assembly parts/Livox Lidar Assembly-0.stp.SLDPRT
evGo-Kart CAD/camera system/Go-Kart & Perception SW files/Livox Lidar Assembly parts/Livox Lidar Assembly-4.stp.SLDPRT
evGo-Kart CAD/camera system/Go-Kart & Perception SW files/Livox Lidar Assembly parts/Mako-G_C-Mount components/Mako_FFL-ZDG-schwarz_CMV2-4000-LGA_C-Mount_montiert_STP-Erstellung.STEP.SLDASM
evGo-Kart CAD/steering frame/True Steering_Kart Assembly SolidWorks files/Custom Parts and Sub-Assemblies/Steering Belt Adjustment Mount/Custom Parts/SpacerCut.SLDASM
evGo-Kart CAD/camera system/Go-Kart & Perception SW files/Livox Lidar Assembly parts/Livox Lidar Assembly.stp.SLDPRT
evGo-Kart CAD/camera system/Go-Kart & Perception SW files/Livox Lidar Assembly parts/Livox Lidar Assembly-2.stp.SLDPRT
evGo-Kart CAD/camera system/Go-Kart & Perception SW files/Livox Lidar Assembly parts/Livox Lidar Assembly-6.stp.SLDPRT
evGo-Kart CAD/camera system/Go-Kart & Perception SW files/Livox Lidar Assembly parts/Livox Lidar Assembly-1.stp.SLDPRT
evGo-Kart CAD/camera system/Go-Kart & Perception SW files/Livox Lidar Assembly parts/Livox Lidar Assembly-3.stp.SLDPRT
evGo-Kart CAD/camera system/Go-Kart & Perception SW files/Livox Lidar Assembly parts/Livox Lidar Assembly-5.stp.SLDPRT
evGo-Kart CAD/camera system/Go-Kart & Perception SW files/Livox Lidar Assembly parts/horizon_out_model_asm components/YC_WJ_ZZ003974_79.stp.SLDPRT
evGo-Kart CAD/camera system/Go-Kart & Perception SW files/MAXPlanetary 3 parts/REV-25-2109_3-Stage components/REV-21-2106.STEP.SLDPRT
evGo-Kart CAD/camera system/Go-Kart & Perception SW files/Livox Lidar Assembly parts/horizon_out_model_asm components/YC_WJ_LL000308_1.stp.SLDPRT
evGo-Kart CAD/camera system/Go-Kart & Perception SW files/MAXPlanetary 3 parts/REV-25-2109_3-Stage components/REV-21-2104.STEP.SLDPRT
evGo-Kart CAD/camera system/Go-Kart & Perception SW files/steering motor assembly comp/steering motor asym.stp.SLDPRT
evGo-Kart CAD/camera system/Go-Kart & Perception SW files/Livox Lidar Assembly parts/horizon_out_model_asm components/YC_WJ_LL000202_01_1.stp.SLDPRT
evGo-Kart CAD/camera system/Go-Kart & Perception SW files/Livox Lidar Assembly parts/horizon_out_model_asm components/YC_XC_DD000261_ASM_8_ASM components/YC_WJ_ZZ004043_1.stp.SLDPRT
evGo-Kart CAD/camera system/Go-Kart & Perception SW files/Livox Lidar Assembly parts/Mako-G_C-Mount components/9533_Flachkopf-Schraube mit KS M2x2.4.STEP.SLDPRT
evGo-Kart CAD/camera system/Go-Kart & Perception SW files/MAXPlanetary 3 parts/REV-25-2109_3-Stage components/REV-21-2108.STEP.SLDPRT
evGo-Kart CAD/camera system/Go-Kart & Perception SW files/Livox Lidar Assembly parts/horizon_out_model_asm components/YC_WJ_ZZ003978_7.stp.SLDPRT
evGo-Kart CAD/camera system/Go-Kart & Perception SW files/Livox Lidar Assembly parts/Mako-G_C-Mount components/4605-_Z04_Mako-PoE_Deckel_nasslackiert+bedruckt_STP-Erstellung ohne Logos.STEP.SLDPRT
evGo-Kart CAD/camera system/Go-Kart & Perception SW files/MAXPlanetary 3 parts/REV-21-2102.stp.SLDPRT
evGo-Kart CAD/camera system/Go-Kart & Perception SW files/Livox Lidar Assembly parts/horizon_out_model_asm components/YC_JD_JD000348_9.stp.SLDPRT
evGo-Kart CAD/camera system/Go-Kart & Perception SW files/Livox Lidar Assembly parts/horizon_out_model_asm components/YC_WJ_LL000431_17.stp.SLDPRT
evGo-Kart CAD/camera system/Go-Kart & Perception SW files/Livox Lidar Assembly parts/horizon_out_model_asm components/VT_FOV_1_20.stp.SLDPRT
evGo-Kart CAD/camera system/Go-Kart & Perception SW files/Livox Lidar Assembly parts/horizon_out_model_asm components/4040_AFB0412VHA_1.stp.SLDPRT
evGo-Kart CAD/camera system/Go-Kart & Perception SW files/Livox Lidar Assembly parts/horizon_out_model_asm components/YC_WJ_L00410_1.stp.SLDPRT
evGo-Kart CAD/camera system/Go-Kart & Perception SW files/Livox Lidar Assembly parts/horizon_out_model_asm components/YC_WJ_LL000294_01_1.stp.SLDPRT
evGo-Kart CAD/camera system/Go-Kart & Perception SW files/Livox Lidar Assembly parts/horizon_out_model_asm components/YC_WJ_ZZ003976_2.stp.SLDPRT
evGo-Kart CAD/camera system/Go-Kart & Perception SW files/Livox Lidar Assembly parts/horizon_out_model_asm components/YC_WJ_L00028_1.stp.SLDPRT
evGo-Kart CAD/camera system/Go-Kart & Perception SW files/Livox Lidar Assembly parts/horizon_out_model_asm components/YC_WJ_L00157_02_3.stp.SLDPRT
evGo-Kart CAD/camera system/Go-Kart & Perception SW files/Livox Lidar Assembly parts/horizon_out_model_asm components/YC_QT_BL000034_25.stp.SLDPRT
evGo-Kart CAD/camera system/Go-Kart & Perception SW files/Go-Kart components/right pedal.SLDPRT
evGo-Kart CAD/camera system/Go-Kart & Perception SW files/Livox Lidar Assembly parts/horizon_out_model_asm components/YC_WJ_ZZ003972_68.stp.SLDPRT
evGo-Kart CAD/camera system/Go-Kart & Perception SW files/Go-Kart components/Tie rod screw.SLDPRT
evGo-Kart CAD/camera system/Go-Kart & Perception SW files/Go-Kart components/Washer.SLDPRT
evGo-Kart CAD/camera system/Go-Kart & Perception SW files/Go-Kart components/washer pitman arm.SLDPRT
evGo-Kart CAD/camera system/Go-Kart & Perception SW files/Livox Lidar Assembly parts/3136N917_T-Slotted Framing.SLDPRT
evGo-Kart CAD/camera system/Go-Kart & Perception SW files/Livox Lidar Assembly parts/47065T749_Black Gusset Bracket.stp.SLDPRT
evGo-Kart CAD/camera system/Go-Kart & Perception SW files/Livox Lidar Assembly parts/5823K81_Corrosion-Resistant Vibration-Damping Sandwich Mount.SLDPRT
evGo-Kart CAD/camera system/Go-Kart & Perception SW files/Livox Lidar Assembly parts/M4 Screw v3 (1)(Mirror).stp.SLDASM
evGo-Kart CAD/camera system/Go-Kart & Perception SW files/Livox Lidar Assembly parts/M4 Screw v3 (1).stp.SLDASM
evGo-Kart CAD/camera system/Go-Kart & Perception SW files/Livox Lidar Assembly parts/M4 Screw v3 component/Component4(Mirror).stp.SLDPRT
evGo-Kart CAD/camera system/Go-Kart & Perception SW files/Livox Lidar Assembly parts/M4 Screw v3 component/Component4.stp.SLDPRT
evGo-Kart CAD/camera system/Go-Kart & Perception SW files/Livox Lidar Assembly parts/M4 Screw v3 component/Component6(Mirror).stp.SLDPRT
evGo-Kart CAD/camera system/Go-Kart & Perception SW files/Livox Lidar Assembly parts/M4 Screw v3 component/Component6.stp.SLDPRT
evGo-Kart CAD/camera system/Go-Kart & Perception SW files/Livox Lidar Assembly parts/M4 Screw v3(Mirror).stp.SLDASM
evGo-Kart CAD/camera system/Go-Kart & Perception SW files/Livox Lidar Assembly parts/M4 Screw v3.stp.SLDASM
evGo-Kart CAD/camera system/Go-Kart & Perception SW files/Livox Lidar Assembly parts/Mako-G_C-Mount components/11044-_Z02_Mako-G_Boden_ZDG_pulverlackiert_St_ckliste.STEP.SLDPRT
evGo-Kart CAD/camera system/Go-Kart & Perception SW files/Livox Lidar Assembly parts/Mako-G_C-Mount components/12443_Mako-G_Rueckwand_montiert__Z03_CMVx-STP-Erstellung.STEP.SLDASM
evGo-Kart CAD/camera system/Go-Kart & Perception SW files/Livox Lidar Assembly parts/Tslot_sensors - Copy.SLDPRT
evGo-Kart CAD/camera system/Go-Kart & Perception SW files/Livox Lidar Assembly parts/Tslot_sensors_20mm - Copy.SLDPRT
evGo-Kart CAD/camera system/Go-Kart & Perception SW files/MAXPlanetary 3 parts/REV-25-2109_3-Stage components/REV-25-2107_3-Stage components/#10 Socket Head Cap Screws_0.500in Long.STEP.SLDPRT
evGo-Kart CAD/camera system/Go-Kart & Perception SW files/MAXPlanetary 3 parts/REV-25-2109_3-Stage components/REV-25-2107_3-Stage components/#10 Socket Head Cap Screws_2.000in Long.STEP.SLDPRT
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
