Triton-AI/evGoKart-mechanical-system/evGo-Kart CAD/camera system/Go-Kart Main Assembly.jpg

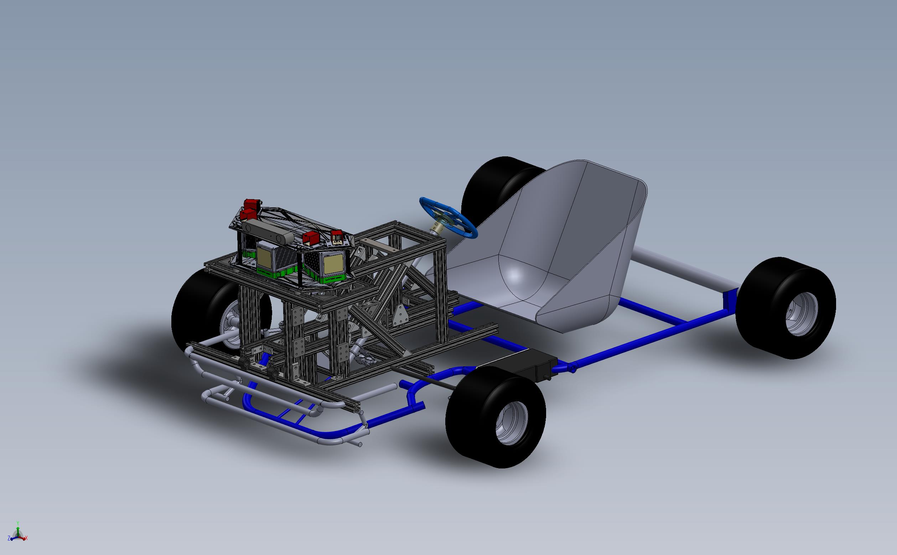
evGo-Kart CAD/camera system/Go-Kart Main Assembly.jpg
