Triton-AI/evGoKart-mechanical-system/(threads)

Thread 1 (2022-04-15):

Rebuilding Shelf & Drawer

narekboghozian, 2022-04-15:
We're making this out of Delron as per regulations. Do we have a new mounting pattern?

Arjun-Naageshwaran, 2022-04-15:
Hey my name is Arjun, I am part of Mechanical team and I am working on the drawer. I consulted Matthew, and he agreed that Delrin isn't strong enough. We are using a 1/16" aluminum plate which we are going to bend using the bending press. I made a proposal for that purchase, but I can't seem to contact Matthew over Basecamp.

narekboghozian, 2022-04-15:
Hi Arjun, I emailed Matthew so he should hopefully see this soon.

> Delrin isn't strong enough

I've been reading the opposite, that Delrin is stronger than Acrylic? @jacksilb did you also discuss this with Matthew?

> I made a proposal for that purchase...

Can you link that proposal here?
What kind of work is going to go in to that construction?
Do you know if we have the parts already?

Arjun-Naageshwaran, 2022-04-15:
I discussed it with Matthew, and he was saying that Delrin is not a preferable alternative to aluminum. From what I understand, I don't think he even considered acrylic.

My proposal isn't for the whole setup, just the piece of aluminum needed for the drawer. Matthew told me to find the right piece of aluminum from the McMaster-Carr website. I based dimensions on the drawer CAD, and talked to Chris Cassidy and Steve from the machine shop about their bending presses. We need 1/16" aluminum sheets which we will then laser cut and bend.

I did not make these decisions, which is why I wanted to consult Matthew, but again I could not contact him on Basecamp.

jacksilb, 2022-04-16:
We need to top self too no?
We can't have Acrylic in the evGoKart.

Can we have a quick design review to do over the CAD/ design?
Otherwise we are going with delrin to not slow down the project. I have been talking about this for weeks. Friday was the dead-line to have the aluminum shelves
Please share the design with us for comments.
We need the shelves done one way or the other by next week. Once we start to put them in the robot will be down.

jacksilb, 2022-04-16:
https://www.refugeforums.com/threads/delrin-vs-acrylic.870866/

I thought I posted something like this already.

I believe we discussed aluminum as the ideal solution, but if we can't get it done this week. We will need to go with delrin.

The MAE 156B team can help.

thanks
-Jack

jacksilb, 2022-04-16:
https://sawmillcreek.org/showthread.php?139045-Plastic-Comparisons-of-Delrin-Acrylic-and-Lexan

jacksilb, 2022-04-16:
https://hackaday.com/2016/03/03/materials-to-know-acetal-and-delrin/

Delrin, Acetal, and its many trade names is a material properly known as Polyoxymethylene or POM. It is one of the strongest plastics and is a good go-to material when you want the best properties of plastic, and don’t need the full strength of a metal part. It was originally formulated to compete with Zinc and Aluminum castings after all.

narekboghozian, 2022-04-16:
> I discussed it with Matthew, and he was saying that Delrin is not a preferable alternative to aluminum. From what I understand, I don't think he even considered acrylic.

@jacksilb he's not saying acrylic is stronger than Delrin.

If we feel that Delrin still not strong enough, let's just reinforce it. But I don't see why we couldn't use aluminum extrusions to make that drawer structure in the first place though.

Regarding the form factor, the laser cutters had trouble carrying out large cuts without failing, so let's break up the shelf into 2, 3, or 4 segments that will be easier to cut. That's a quick change that will take less time than re-doing the entire thing.

Arjun-Naageshwaran, 2022-04-17:
Hey sorry for the late response, I was traveling this weekend. @jacksilb I sent you the CAD screenshots and the selection of aluminum sheet I made from the McMaster-Carr website. Is that suitable? Or should we start with the Delrin?

jacksilb, 2022-04-17:
Please review with the MAE students the design ASAP.
The window is closing to use Aluminum

Thanks,
-Jack
----

On Sun, Apr 17, 2022 at 4:11 PM Arjun-Naageshwaran ***@***.***>
wrote:

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

narekboghozian, 2022-04-17:
@Arjun-Naageshwaran  can you post that here?

GriffinBorn, 2022-04-18:
Hello guys my name is Jack Griffin, I am from the MAE 156B team,
I can see you guys are still somewhat deciding between Aluminum and Delrin, I would like to add that I did do some analysis and found that Delrin should hold up well, and if necessary we could add some aluminum supports to help aleviate stress due to vibrations. Also it was Actually my MAE professor, Professor Delson, who actually recommended the use of Delrin during our early design proposals last quarter when discussing an alternative for Acrylic that is stronger and not as expensive as Aluminum. Much of the simulations was also based on impact since we were looking at shatter resistance and found Delrin to hold well. Here is a table that compares the specs of the materials.

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

If you guys have any more questions, or need assistance with machining please feel free to message me and we can figure things out.

Arjun-Naageshwaran, 2022-04-18:
@jacksilb @narekboghozian
Hello, after reviewing the attached CAD models for dimensions and bending style, I have selected the attached aluminum sheet. We have to use the 24" x 48" aluminum sheet that is 0.062" thick, since that thickness is the thickest that will fit into the bending press.

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

Arjun-Naageshwaran, 2022-04-18:
The dimensions of the drawer cutout are 34.68" x 14.118". As I said above, the 24" x 48" aluminum sheet will cover these dimensions. It is $111.64 which is more expensive than the Delrin

Arjun-Naageshwaran, 2022-04-18:
Apologies for the delay on this, I sent it to @jacksilb earlier, but wanted to run it by Matthew too. Although I have not been able to contact him.

Arjun-Naageshwaran, 2022-04-18:
It is also worth noting that Matthew was staunchly against Delrin for this purpose. I have not looked into either extensively enough.

GriffinBorn, 2022-04-18:
I understand this is for the inside drawer, will the top shelf also be cut from aluminum? Remember all forms of acrylic on the kart needs to be replaced.
Also will 0.062" be strong enough to hold up the electronics? Because at least to me that seems very thin and will very easily bend under the weight of the electronics. Have you done force simulations on the drawer? Because I was under the assumption that if we would use aluminum we would at least be 1/8" which is twice this thickness.

GriffinBorn, 2022-04-18:
Ok so my filing cabinet drawer is about 0.062" thick aluminum so this thickness of aluminum could work, however, my drawer is much smaller than what the drawer on the kart would be and is held together from all sides, so some buckling/static force simulations would be nice to see before creating this piece to ensure it will support all the weight.
Also, I updated the Fusion part so that it is now of the correct aluminum material.

GriffinBorn, 2022-04-18:
Also when you do a simulation, make sure to update the body thickness. I had a look at the Fusion cad and right now it is about 3x the thickness of the actual aluminum you are planning on using.

Regarding the simulations, I recommend making 0.0001" cuts in the shape of the mounts or electronics that will be placed on the shelf itself, then applying the force of their weight on those cut sections.

Here is an example how I did it on a plate I created last year (this was made in Solidworks but it should be the same in Fusion):

This is what it looks like normally:
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

This is what it looks like with the small cuts:
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

This is what it looks like when I apply force to those certain sections:
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

You should be able to do something similar and much easier with a couple of squares.

GriffinBorn, 2022-04-18:
Doing a model frequency analysis may be useful as well.

Arjun-Naageshwaran, 2022-04-18:
Those are all solid suggestions. The reasoning behind 1/16" is that it is simply the maximum thickness both bending presses we have access to can bend. At this point, since Matthew has been out of communication, Delrin might have to be our option. I've been trying to get his advice on this since last Tuesday to fill the gaps in my knowledge, but he is off Basecamp and not responding on discord.

Arjun-Naageshwaran, 2022-04-19:
@jacksilb because Matthew hasn't responses, I guess we are going with Delrin? I can begin adjusting the CAD with supports accordingly.

jacksilb, 2022-04-19:
Fellows, we need a design review soon and move on.
Let's do Delrin for now. Easy to laser cut. Please talk to @acastane and the MAE 156 team today and let me know what to buy. I can go to the plastic store tomorrow and assuming they have in stock get Delrin. @narekboghozian and @genesis already have a simple solution to add extra support. One simple bar across the bottom shelve should do it. We have the stock at home. We can do the cross bar today if someone can just cut and tap it.

In summary, what size of Delrin plates you want me to get and the thickness. Lets rock!

Arjun-Naageshwaran, 2022-04-20:
I don't have any of the contact info for the MAE 156 team, does anyone on this thread have it?

GriffinBorn, 2022-04-20:
I am one of the members of the 156 team, Adrian (one of the other MAE 156 team members) and I will be in Jack's lab tomorrow if you are able to come in and we can discuss things. Otherwise, I will provide our emails here and you can group email us:
- jsgriffi@ucsd.edu
- acastane@ucsd.edu
- d1qiao@ucsd.ed
- hkn013@ucsd.edu

Arjun-Naageshwaran, 2022-04-20:
@GriffinBorn I can't make it to the lab, but I will def email you.

GriffinBorn, 2022-04-25:
@Arjun-Naageshwaran Do you have the sketches or DXF's for the shelf parts that we need to laser cut? We have the Delrin sheets in the lab so as soon as we have the sketches for the parts we can get them cut.

jacksilb, 2022-04-25:
I believe Vlad and Colling said they have them too.

colin-szeto, 2022-04-25:
[top plate and all parts bottom plate.zip](https://github.com/Triton-AI/evGoKart-mechanical-system/files/8558100/top.plate.and.all.parts.bottom.plate.zip)

See attached file. Let me know if you have any questions

jacksilb, 2022-04-25:
Nice.

Lets laser cut them as quickly as possible. Good timing to change them
before we start the test outside. We are behind the schedule. We have not
stop once we the robot ready for software development.

Thanks,
-Jack
----

On Mon, Apr 25, 2022 at 2:26 PM Colin Szeto ***@***.***>
wrote:

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

GriffinBorn, 2022-04-26:
So I tried to open these files and was wondering if they were made to fit the delrin sheets we have? Also the Top Plate dxf seems to not have any lines or holes; and then rev4Allparts file seems to have some overlap in some area. Is it supposed to be like this?
Here are images of both; the top plate I filled to see if I can see the holes but there seems to not be any strokes/lines they would be blue if they were there. The other parts seem to overlap and have some weird lines.
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
The dimensions also seem to be off, that could be a my side thing but I am not sure

colin-szeto, 2022-04-26:
Hmm opening them in adobe illustrator may not be the best idea as the dxf were generated in AutoCAD.

I don't know the dimensions of the delrin in the lab, could you provide them>

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

^these are what they look like in autocad

GriffinBorn, 2022-04-26:
Ah perfect, just wanted to make sure, I don't have AutoCAD on my computer so it is good that it looks good there. Here are the max dimensions that are allowed in the laser cutter, and I believe this matches the dimensions of the sheets we have.
2' x 4'

colin-szeto, 2022-04-26:
@GriffinBorn

Here are the updated files. These have 20mm by 20mm hole patterns
[to github.zip](https://github.com/Triton-AI/evGoKart-mechanical-system/files/8561033/to.github.zip)
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

GriffinBorn, 2022-04-26:
Would it be possible to do 15mm x 15 mm distance hole pattern in this area?
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

One of my other team members is mounting the vesc and says the center distance between holes for the VESC mount is 75 mm.

colin-szeto, 2022-04-26:
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
[top top plate with 15 by 15.zip](https://github.com/Triton-AI/evGoKart-mechanical-system/files/8561513/top.top.plate.with.15.by.15.zip)

The 15 by 15 hole pattern is attached above

GriffinBorn, 2022-04-26:
Thanks, I'll see about getting these cut tomorrow then.

GriffinBorn, 2022-04-26:
@colin-szeto I showed my teammate and he just replied to me saying he actually needs the outer holes for that section to be 15mm apart also if possible . If not he can figure out another way to mount, but it would make things easier if they were.

colin-szeto, 2022-04-26:
@GriffinBorn

![image](https://user-images.githu
[top top plate with 15 by 15 leddge outer.zip](https://github.com/Triton-AI/evGoKart-mechanical-system/files/8564222/top.top.plate.with.15.by.15.leddge.outer.zip)
busercontent.com/29698074/165326697-53fb8e1d-9705-4423-be0f-addda60351b4.png)

GriffinBorn, 2022-04-26:
Perfect thanks 👍

Arjun-Naageshwaran, 2022-04-26:
@GriffinBorn I am so sorry, I have been super busy with midterms last week, and continue to be this week. Let me know if you need anything further with the drawer.

GriffinBorn, 2022-05-02:
@narekboghozian Could you update and provide me the dxf files for this electrical stack so we can make it into Delrin. Also as a note from what I noticed when doing the main shelf, please update the dimensions for 0.25" material which is also around 6mm; I just noticed that the previous holes for slotting the parts together were very tight and I had to sand the holes down and it was because they weren't adjusted from the original 5mm thickness to the new 0.25" thickness. So if I could get those dxf files tonight or tomorrow morning so we can get those cut ASAP that would be great, thank you.
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
Image for reference of what I am talking about.

Thread 3 (2022-04-18):

Electronics dust cover

narekboghozian, 2022-04-18:
The sides of the electronics area are exposed right where the wheels are. This is gonna kick up dirt onto the electronics. How is this going to be prevented? At least to protect the ADLINK.
