Triton-AI/evGoKart-mechanical-system/(commit log)

2022-07-23 Create evGo-Kart CAD
2022-07-23 Create True Steering_Kart assembly
2022-07-23 Create True Steering_Kart Assembly SolidWorks files
2022-07-23 Create steering frame
2022-07-24 Add files via upload
    html straight to an eDrawing of the True Dimensioned Steering Structure
